butterstick-fpga/butterstick-hardware/hardware/ButterStick_r0.2/ButterStick.kicad_pcb

## KiCad design hardware/ButterStick_r0.2/ButterStick.kicad_pcb (2019-06-14)

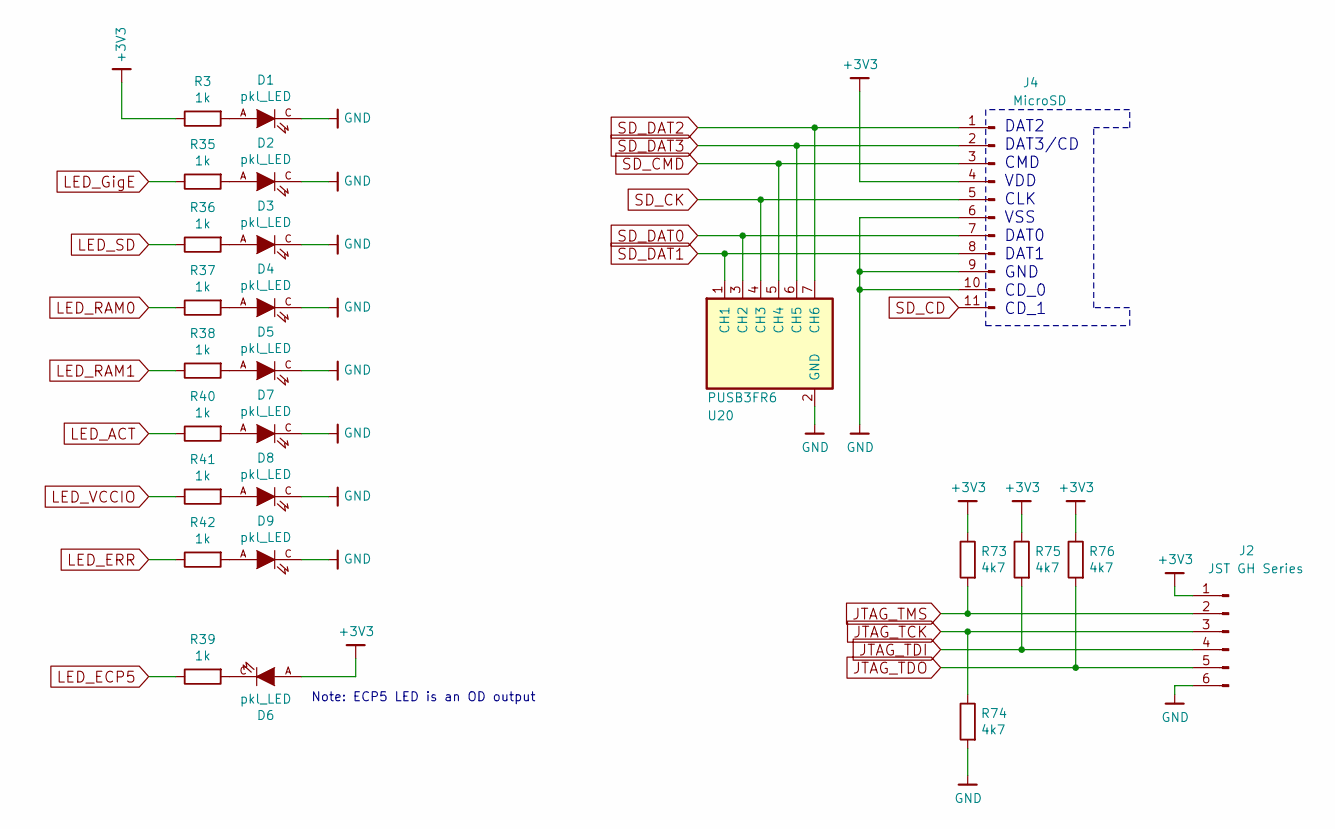
[picture p1: schematic fileIO.sch, ButterStick]

Parts:
D1, D2, D3, D4, D5, D6, D7, D8, D9: pkl_LED; D_0603
J2: JST GH Series; JST_GH_BM06B-GHS-TBT_06x1.25mm_Straight
J4: MicroSD; molex_microsd_1040310811
R3, R35, R36, R37, R38, R39, R40, R41, R42: 1k; R_0402
R73, R74, R75, R76: 4k7; R_0402
U20: PUSB3FR6; XSON7

Connections:
+3V3: D6.A, J2.1, J4.4, R3.1, R73.1, R75.1, R76.1; also elsewhere on the board
GND: D1.C, D2.C, D3.C, D4.C, D5.C, D7.C, D8.C, D9.C, J2.6, J4.6, J4.9, J4.10, R74.2, U20.2 (GND); also elsewhere on the board
JTAG_TCK: J2.3, R74.1; also elsewhere on the board
JTAG_TDI: J2.4, R75.2; also elsewhere on the board
JTAG_TDO: J2.5, R76.2; also elsewhere on the board
JTAG_TMS: J2.2, R73.2; also elsewhere on the board
LED_ACT: R40.1; also elsewhere on the board
LED_ECP5: R39.1; also elsewhere on the board
LED_ERR: R42.1; also elsewhere on the board
LED_GigE: R35.1; also elsewhere on the board
LED_RAM0: R37.1; also elsewhere on the board
LED_RAM1: R38.1; also elsewhere on the board
LED_SD: R36.1; also elsewhere on the board
LED_VCCIO: R41.1; also elsewhere on the board
unnamed: D1.A, R3.2
unnamed: D2.A, R35.2
unnamed: D3.A, R36.2
unnamed: D4.A, R37.2
unnamed: D5.A, R38.2
unnamed: D6.C, R39.2
unnamed: D7.A, R40.2
unnamed: D8.A, R41.2
unnamed: D9.A, R42.2
SD_CD: J4.11; also elsewhere on the board
SD_CK: J4.5, U20.4 (CH3); also elsewhere on the board
SD_CMD: J4.3, U20.5 (CH4); also elsewhere on the board
SD_DAT0: J4.7, U20.3 (CH2); also elsewhere on the board
SD_DAT1: J4.8, U20.1 (CH1); also elsewhere on the board
SD_DAT2: J4.1, U20.7 (CH6); also elsewhere on the board
SD_DAT3: J4.2, U20.6 (CH5); also elsewhere on the board

Notes on the sheet:
DAT2 DAT3/CD CMD VDD CLK VSS DAT0 DAT1 GND CD_0 CD_1
Note: ECP5 LED is an OD output

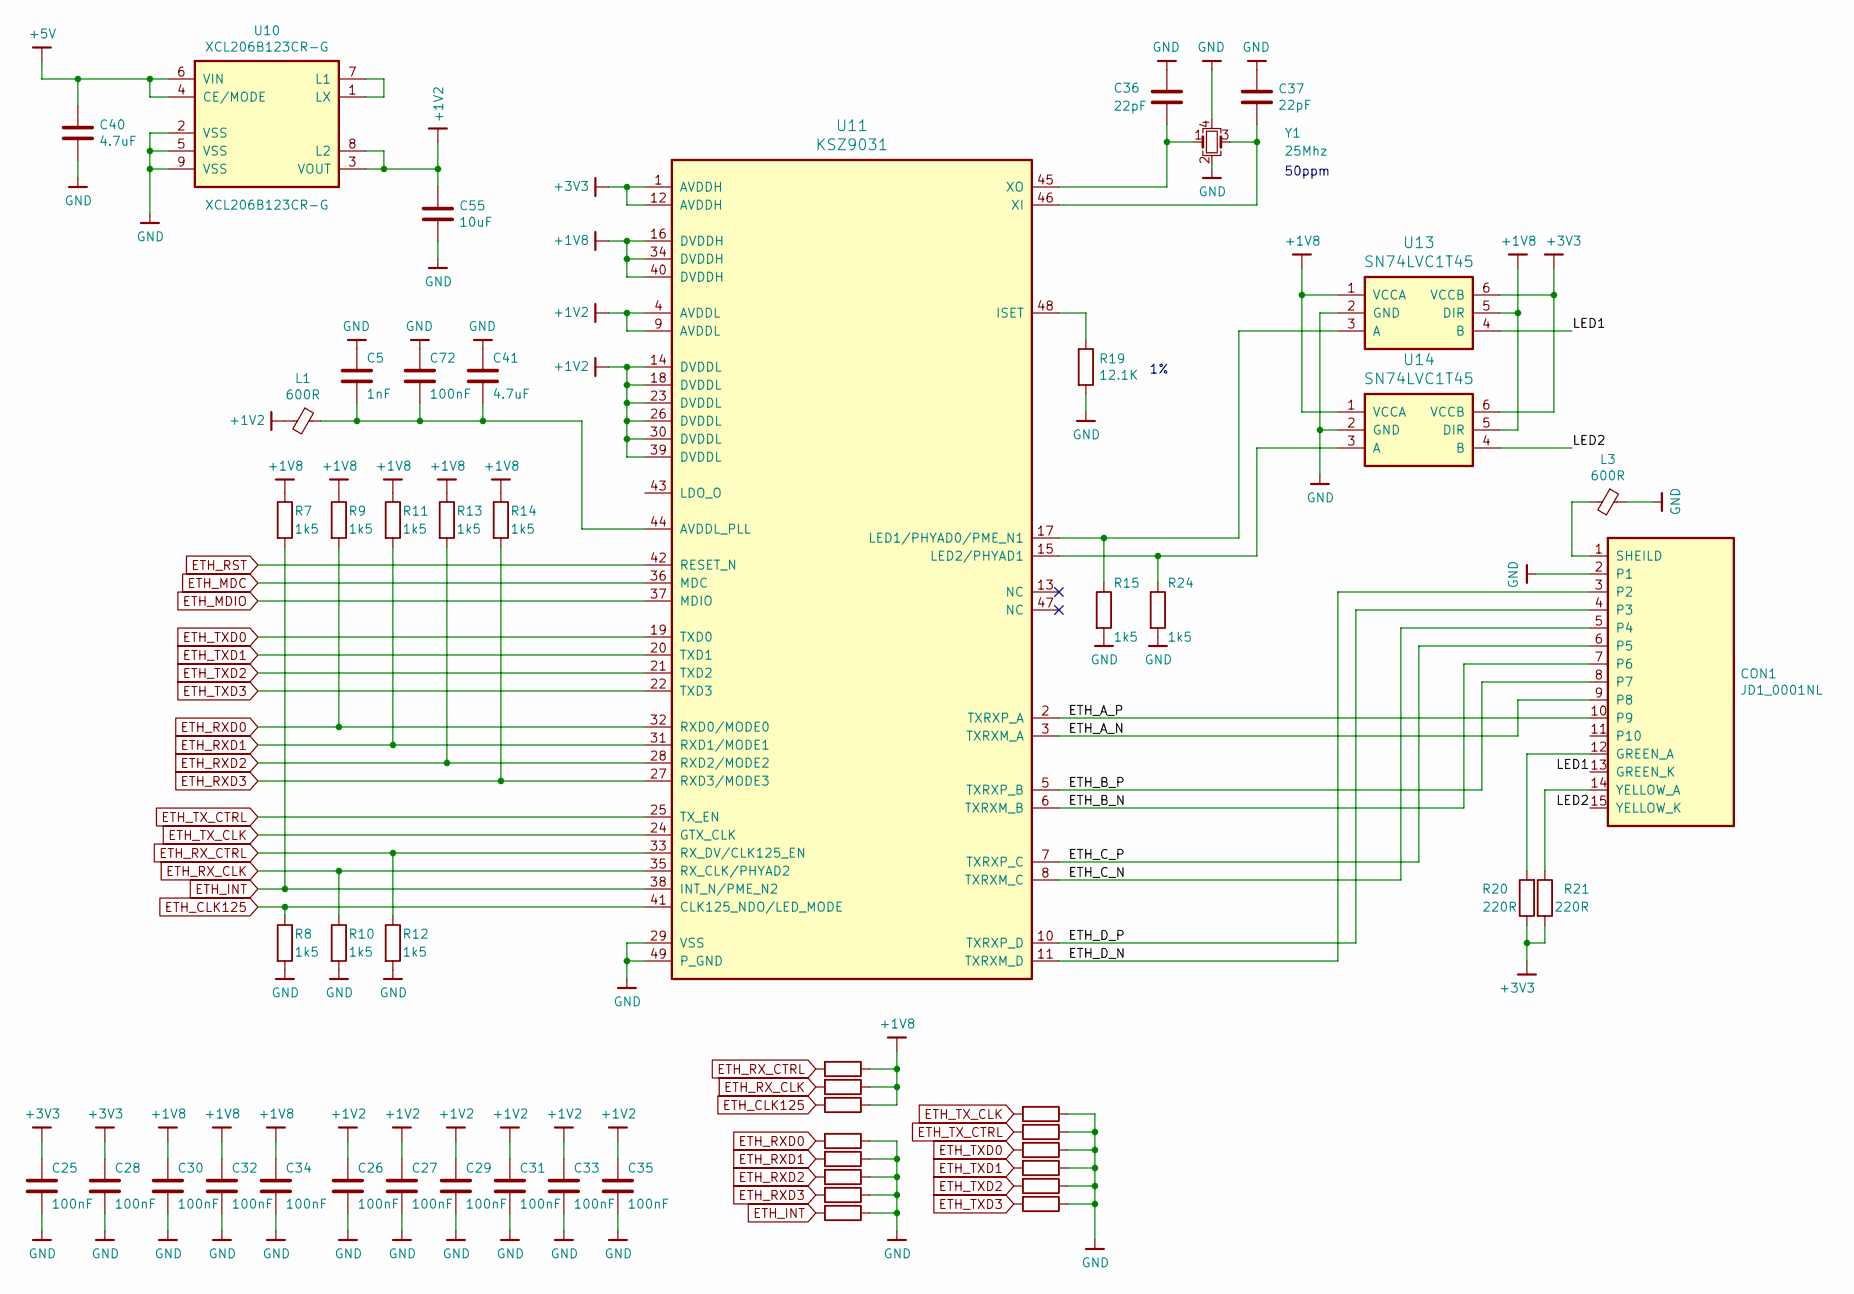
[picture p2: schematic fileEthernet.sch, ButterStick]

Parts:
C5: 1nF; C_0402
C25, C26, C27, C28, C29, C30, C31, C32, C33, C34, C35, C72: 100nF; C_0402
C36, C37: 22pF; C_0402
C40, C41: 4.7uF; C_0603
C55: 10uF; C_0603
CON1: JD1_0001NL; MAGJACK
L1: 600R; L_0402
L3: 600R; L_0603
R7, R8, R9, R10, R11, R12, R13, R14, R15, R24: 1k5; R_0402
R19: 12.1K; R_0603
R20, R21: 220R; R_0402
R48, R49, R50, R51, R52, R55, R64, R65, R67, R68, R69, R70, R71, R72: DNP; R_0402
U10: XCL206B123CR-G; CL-2025
U11: KSZ9031; QFN-48-1EP_7x7mm_Pitch0.5mm
U13, U14: SN74LVC1T45; SOT-666
Y1: 25Mhz; Oscillator_SMD_SeikoEpson_SG210-4pin_2.5x2.0mm

Connections:
+1V2: C26.1, C27.1, C29.1, C31.1, C33.1, C35.1, C55.1, L1.2, U10.3 (VOUT), U10.8 (L2), U11.4 (AVDDL~), U11.9 (AVDDL~), U11.14 (DVDDL), U11.18 (DVDDL), U11.23 (DVDDL), U11.26 (DVDDL), U11.30 (DVDDL), U11.39 (DVDDL)
+1V8: C30.1, C32.1, C34.1, R7.1, R9.1, R11.1, R13.1, R14.1, R48.1, R49.1, R50.1, U11.16 (DVDDH), U11.34 (DVDDH), U11.40 (DVDDH), U13.1 (VCCA), U13.5 (DIR), U14.1 (VCCA), U14.5 (DIR); also elsewhere on the board
+3V3: C25.1, C28.1, R20.1, R21.2, U11.1 (AVDDH), U11.12 (AVDDH), U13.6 (VCCB), U14.6 (VCCB); also elsewhere on the board
+5V: C40.1, U10.4 (CE/MODE), U10.6 (VIN); also elsewhere on the board
/sheetEthernet/ETH_A_N: CON1.9 (P8), U11.3 (TXRXM_A)
/sheetEthernet/ETH_A_P: CON1.10 (P9), U11.2 (TXRXP_A)
/sheetEthernet/ETH_B_N: CON1.7 (P6), U11.6 (TXRXM_B)
/sheetEthernet/ETH_B_P: CON1.8 (P7), U11.5 (TXRXP_B)
/sheetEthernet/ETH_C_N: CON1.5 (P4), U11.8 (TXRXM_C)
/sheetEthernet/ETH_C_P: CON1.6 (P5), U11.7 (TXRXP_C)
/sheetEthernet/ETH_D_N: CON1.3 (P2), U11.11 (TXRXM_D)
/sheetEthernet/ETH_D_P: CON1.4 (P3), U11.10 (TXRXP_D)
/sheetEthernet/LED1: CON1.13 (GREEN_K), U13.4 (B)
/sheetEthernet/LED2: CON1.15 (YELLOW_K), U14.4 (B)
ETH_CLK125: R8.1, R50.2, U11.41 (CLK125_NDO/LED_MODE); also elsewhere on the board
ETH_INT: R7.2, R65.2, U11.38 (INT_N/PME_N2); also elsewhere on the board
ETH_MDC: U11.36 (MDC); also elsewhere on the board
ETH_MDIO: U11.37 (MDIO); also elsewhere on the board
ETH_RST: U11.42 (RESET_N); also elsewhere on the board
ETH_RXD0: R9.2, R51.2, U11.32 (RXD0/MODE0); also elsewhere on the board
ETH_RXD1: R11.2, R52.2, U11.31 (RXD1/MODE1); also elsewhere on the board
ETH_RXD2: R13.2, R55.2, U11.28 (RXD2/MODE2); also elsewhere on the board
ETH_RXD3: R14.2, R64.2, U11.27 (RXD3/MODE3); also elsewhere on the board
ETH_RX_CLK: R10.1, R49.2, U11.35 (RX_CLK/PHYAD2); also elsewhere on the board
ETH_RX_CTRL: R12.1, R48.2, U11.33 (RX_DV/CLK125_EN); also elsewhere on the board
ETH_TXD0: R69.2, U11.19 (TXD0); also elsewhere on the board
ETH_TXD1: R70.2, U11.20 (TXD1); also elsewhere on the board
ETH_TXD2: R71.2, U11.21 (TXD2); also elsewhere on the board
ETH_TXD3: R72.2, U11.22 (TXD3); also elsewhere on the board
ETH_TX_CLK: R67.2, U11.24 (GTX_CLK); also elsewhere on the board
ETH_TX_CTRL: R68.2, U11.25 (TX_EN); also elsewhere on the board
GND: C5.1, C25.2, C26.2, C27.2, C28.2, C29.2, C30.2, C31.2, C32.2, C33.2, C34.2, C35.2, C36.1, C37.1, C40.2, C41.1, C55.2, C72.1, CON1.2 (P1), L3.1, R8.2, R10.2, R12.2, R15.2, R19.2, R24.2, R51.1, R52.1, R55.1, R64.1, R65.1, R67.1, R68.1, R69.1, R70.1, R71.1, R72.1, U10.2 (VSS), U10.5 (VSS), U10.9 (VSS), U11.29 (VSS), U11.49 (P_GND), U13.2 (GND), U14.2 (GND), Y1.2, Y1.4; also elsewhere on the board
unnamed: C36.2, U11.45 (XO), Y1.1
unnamed: C37.2, U11.46 (XI), Y1.3
unnamed: C5.2, C41.2, C72.2, L1.1, U11.44 (AVDDL_PLL)
unnamed: CON1.1 (SHEILD), L3.2
unnamed: CON1.12 (GREEN_A), R20.2
unnamed: CON1.14 (YELLOW_A), R21.1
unnamed: R15.1, U11.17 (LED1/PHYAD0/PME_N1), U13.3 (A)
unnamed: R19.1, U11.48 (ISET)
unnamed: R24.1, U11.15 (LED2/PHYAD1), U14.3 (A)
unnamed: U10.1 (LX), U10.7 (L1)

Notes on the sheet:
50ppm

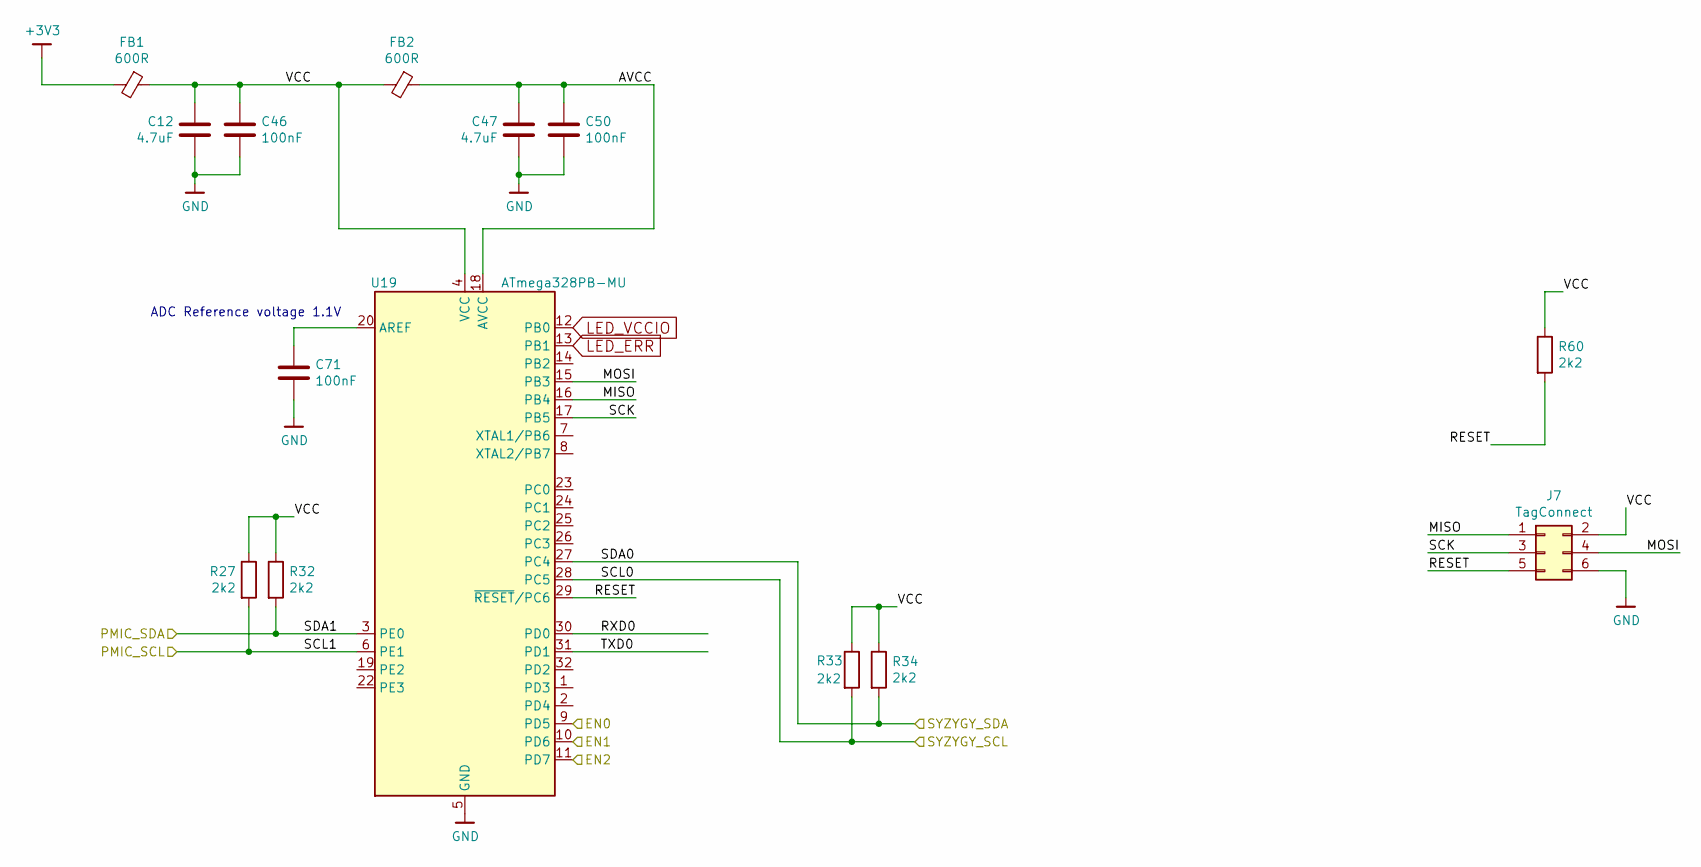
[picture p3: schematic SmartVIO.sch, ButterStick]

Parts:
C12, C47: 4.7uF; C_0603
C46, C50, C71: 100nF; C_0402
FB1, FB2: 600R; L_0402
J7: TagConnect; TC2030-NL_SMALL
R27, R32, R33, R34, R60: 2k2; R_0402
U19: ATmega328PB-MU; QFN-32-1EP_5x5mm_P0.5mm_EP3.1x3.1mm

Connections:
+3V3: FB1.2; also elsewhere on the board
/SmartVIO/AVCC: C47.1, C50.1, FB2.1, U19.18 (AVCC)
/SmartVIO/MISO: J7.1, U19.16 (PB4)
/SmartVIO/MOSI: J7.4, U19.15 (PB3)
/SmartVIO/PMIC_SCL: R27.2, U19.6 (PE1); also elsewhere on the board
/SmartVIO/PMIC_SDA: R32.2, U19.3 (PE0); also elsewhere on the board
/SmartVIO/RESET: J7.5, R60.2, U19.29 (~RESET~/PC6)
/SmartVIO/RXD0: U19.30 (PD0)
/SmartVIO/SCK: J7.3, U19.17 (PB5)
/SmartVIO/SYZYGY_SCL: R33.2, U19.28 (PC5); also elsewhere on the board
/SmartVIO/SYZYGY_SDA: R34.2, U19.27 (PC4); also elsewhere on the board
/SmartVIO/TXD0: U19.31 (PD1)
/SmartVIO/VCC: C12.1, C46.1, FB1.1, FB2.2, J7.2, R27.1, R32.1, R33.1, R34.1, R60.1, U19.4 (VCC)
/SyzygyPort0/EN: U19.9 (PD5); also elsewhere on the board
/SyzygyPort1/EN: U19.10 (PD6); also elsewhere on the board
/SyzygyPort2/EN: U19.11 (PD7); also elsewhere on the board
GND: C12.2, C46.2, C47.2, C50.2, C71.2, J7.6, U19.5 (GND), U19.21 (GND), U19.33 (GND); also elsewhere on the board
LED_ERR: U19.13 (PB1); also elsewhere on the board
LED_VCCIO: U19.12 (PB0); also elsewhere on the board
unnamed: C71.1, U19.20 (AREF)

Notes on the sheet:
ADC Reference voltage 1.1V

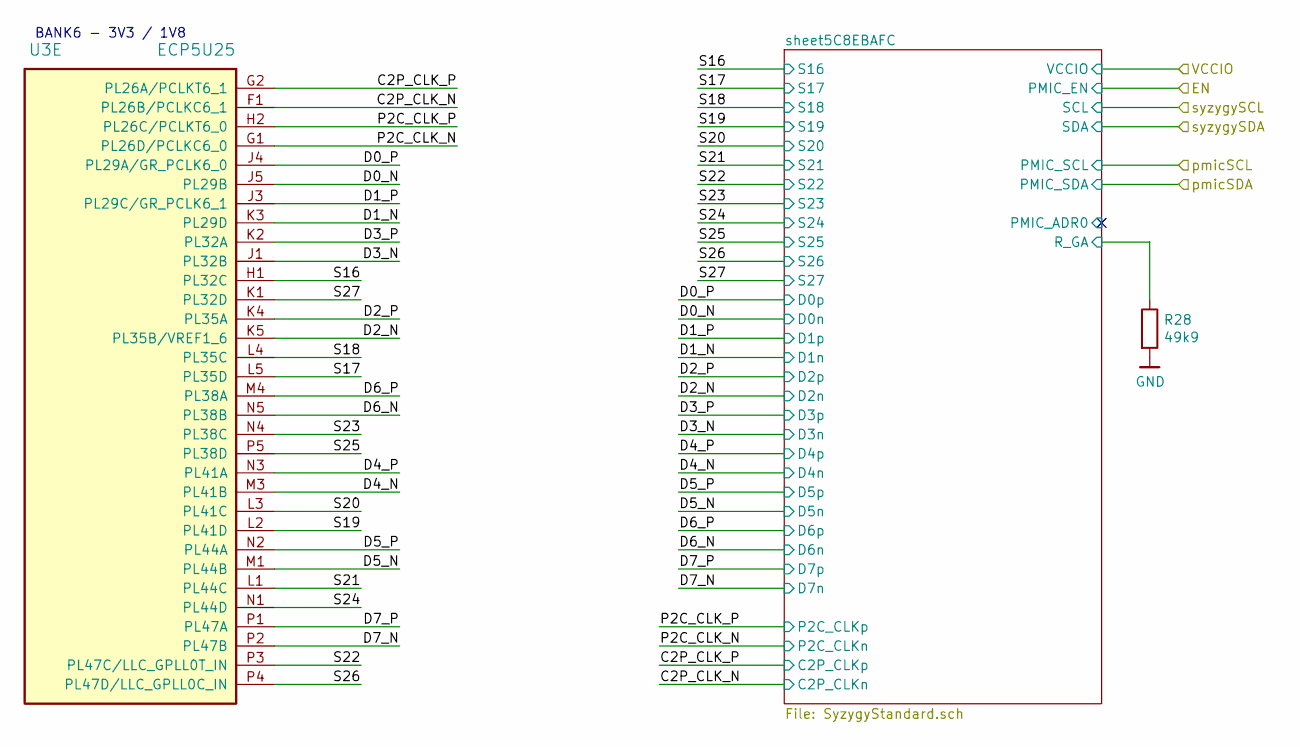
[picture p4: schematic SYZYGY_PORT2.sch, ButterStick]

Parts:
R28: 49k9; R_0402
U3: ECP5U25; caBGA_381_17x17

Connections:
/SyzygyPort2/C2P_CLK_N: U3.F1 (PL26B/PCLKC6_1); also elsewhere on the board
/SyzygyPort2/C2P_CLK_P: U3.G2 (PL26A/PCLKT6_1); also elsewhere on the board
/SyzygyPort2/D0_N: U3.J5 (PL29B); also elsewhere on the board
/SyzygyPort2/D0_P: U3.J4 (PL29A/GR_PCLK6_0); also elsewhere on the board
/SyzygyPort2/D1_N: U3.K3 (PL29D); also elsewhere on the board
/SyzygyPort2/D1_P: U3.J3 (PL29C/GR_PCLK6_1); also elsewhere on the board
/SyzygyPort2/D2_N: U3.K5 (PL35B/VREF1_6); also elsewhere on the board
/SyzygyPort2/D2_P: U3.K4 (PL35A); also elsewhere on the board
/SyzygyPort2/D3_N: U3.J1 (PL32B); also elsewhere on the board
/SyzygyPort2/D3_P: U3.K2 (PL32A); also elsewhere on the board
/SyzygyPort2/D4_N: U3.M3 (PL41B); also elsewhere on the board
/SyzygyPort2/D4_P: U3.N3 (PL41A); also elsewhere on the board
/SyzygyPort2/D5_N: U3.M1 (PL44B); also elsewhere on the board
/SyzygyPort2/D5_P: U3.N2 (PL44A); also elsewhere on the board
/SyzygyPort2/D6_N: U3.N5 (PL38B); also elsewhere on the board
/SyzygyPort2/D6_P: U3.M4 (PL38A); also elsewhere on the board
/SyzygyPort2/D7_N: U3.P2 (PL47B); also elsewhere on the board
/SyzygyPort2/D7_P: U3.P1 (PL47A); also elsewhere on the board
/SyzygyPort2/P2C_CLK_N: U3.G1 (PL26D/PCLKC6_0); also elsewhere on the board
/SyzygyPort2/P2C_CLK_P: U3.H2 (PL26C/PCLKT6_0); also elsewhere on the board
/SyzygyPort2/S16: U3.H1 (PL32C); also elsewhere on the board
/SyzygyPort2/S17: U3.L5 (PL35D); also elsewhere on the board
/SyzygyPort2/S18: U3.L4 (PL35C); also elsewhere on the board
/SyzygyPort2/S19: U3.L2 (PL41D); also elsewhere on the board
/SyzygyPort2/S20: U3.L3 (PL41C); also elsewhere on the board
/SyzygyPort2/S21: U3.L1 (PL44C); also elsewhere on the board
/SyzygyPort2/S22: U3.P3 (PL47C/LLC_GPLL0T_IN); also elsewhere on the board
/SyzygyPort2/S23: U3.N4 (PL38C); also elsewhere on the board
/SyzygyPort2/S24: U3.N1 (PL44D); also elsewhere on the board
/SyzygyPort2/S25: U3.P5 (PL38D); also elsewhere on the board
/SyzygyPort2/S26: U3.P4 (PL47D/LLC_GPLL0C_IN); also elsewhere on the board
/SyzygyPort2/S27: U3.K1 (PL32D); also elsewhere on the board
/SyzygyPort2/sheet5C8EBAFC/R_GA: R28.1; also elsewhere on the board
GND: R28.2; also elsewhere on the board

Notes on the sheet:
BANK6 - 3V3 / 1V8

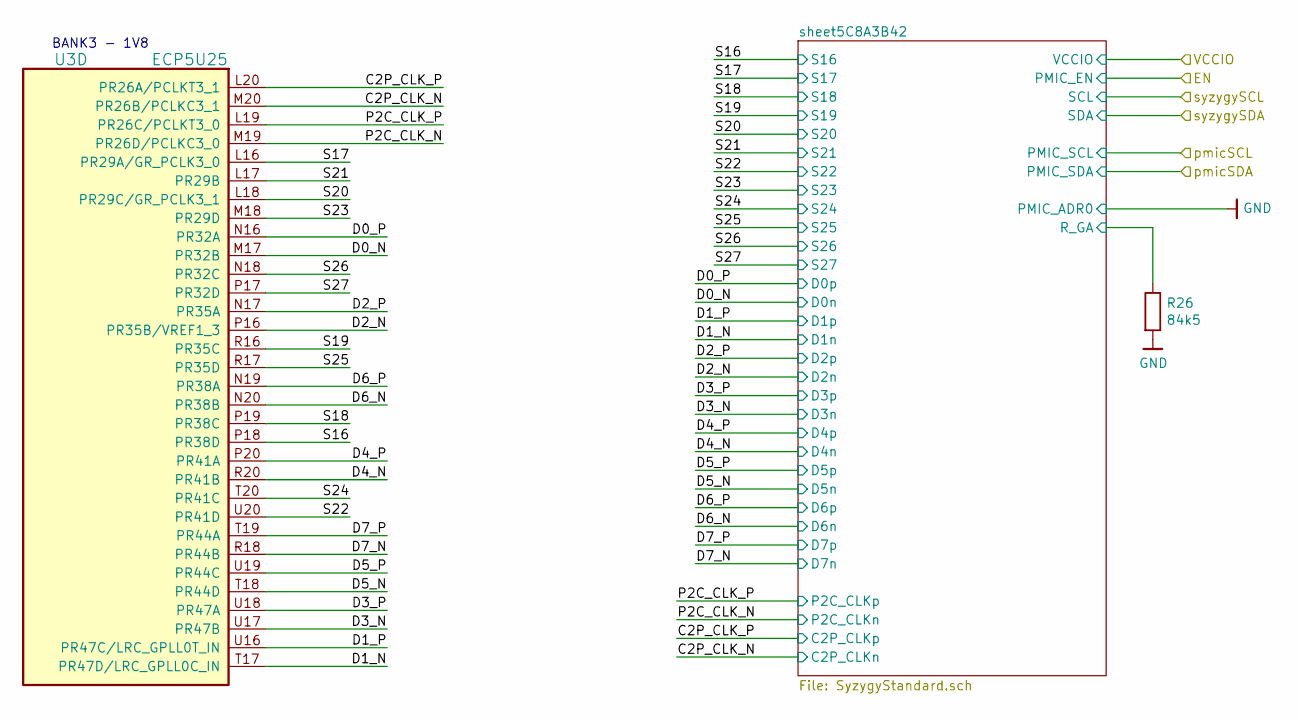
[picture p5: schematic SYZYGY_PORT1.sch, ButterStick]

Parts:
R26: 84k5; R_0402
U3: ECP5U25; caBGA_381_17x17

Connections:
/SyzygyPort1/C2P_CLK_N: U3.M20 (PR26B/PCLKC3_1); also elsewhere on the board
/SyzygyPort1/C2P_CLK_P: U3.L20 (PR26A/PCLKT3_1); also elsewhere on the board
/SyzygyPort1/D0_N: U3.M17 (PR32B); also elsewhere on the board
/SyzygyPort1/D0_P: U3.N16 (PR32A); also elsewhere on the board
/SyzygyPort1/D1_N: U3.T17 (PR47D/LRC_GPLL0C_IN); also elsewhere on the board
/SyzygyPort1/D1_P: U3.U16 (PR47C/LRC_GPLL0T_IN); also elsewhere on the board
/SyzygyPort1/D2_N: U3.P16 (PR35B/VREF1_3); also elsewhere on the board
/SyzygyPort1/D2_P: U3.N17 (PR35A); also elsewhere on the board
/SyzygyPort1/D3_N: U3.U17 (PR47B); also elsewhere on the board
/SyzygyPort1/D3_P: U3.U18 (PR47A); also elsewhere on the board
/SyzygyPort1/D4_N: U3.R20 (PR41B); also elsewhere on the board
/SyzygyPort1/D4_P: U3.P20 (PR41A); also elsewhere on the board
/SyzygyPort1/D5_N: U3.T18 (PR44D); also elsewhere on the board
/SyzygyPort1/D5_P: U3.U19 (PR44C); also elsewhere on the board
/SyzygyPort1/D6_N: U3.N20 (PR38B); also elsewhere on the board
/SyzygyPort1/D6_P: U3.N19 (PR38A); also elsewhere on the board
/SyzygyPort1/D7_N: U3.R18 (PR44B); also elsewhere on the board
/SyzygyPort1/D7_P: U3.T19 (PR44A); also elsewhere on the board
/SyzygyPort1/P2C_CLK_N: U3.M19 (PR26D/PCLKC3_0); also elsewhere on the board
/SyzygyPort1/P2C_CLK_P: U3.L19 (PR26C/PCLKT3_0); also elsewhere on the board
/SyzygyPort1/S16: U3.P18 (PR38D); also elsewhere on the board
/SyzygyPort1/S17: U3.L16 (PR29A/GR_PCLK3_0); also elsewhere on the board
/SyzygyPort1/S18: U3.P19 (PR38C); also elsewhere on the board
/SyzygyPort1/S19: U3.R16 (PR35C); also elsewhere on the board
/SyzygyPort1/S20: U3.L18 (PR29C/GR_PCLK3_1); also elsewhere on the board
/SyzygyPort1/S21: U3.L17 (PR29B); also elsewhere on the board
/SyzygyPort1/S22: U3.U20 (PR41D); also elsewhere on the board
/SyzygyPort1/S23: U3.M18 (PR29D); also elsewhere on the board
/SyzygyPort1/S24: U3.T20 (PR41C); also elsewhere on the board
/SyzygyPort1/S25: U3.R17 (PR35D); also elsewhere on the board
/SyzygyPort1/S26: U3.N18 (PR32C); also elsewhere on the board
/SyzygyPort1/S27: U3.P17 (PR32D); also elsewhere on the board
/SyzygyPort1/sheet5C8A3B42/R_GA: R26.1; also elsewhere on the board
GND: R26.2; also elsewhere on the board

Notes on the sheet:
BANK3 - 1V8

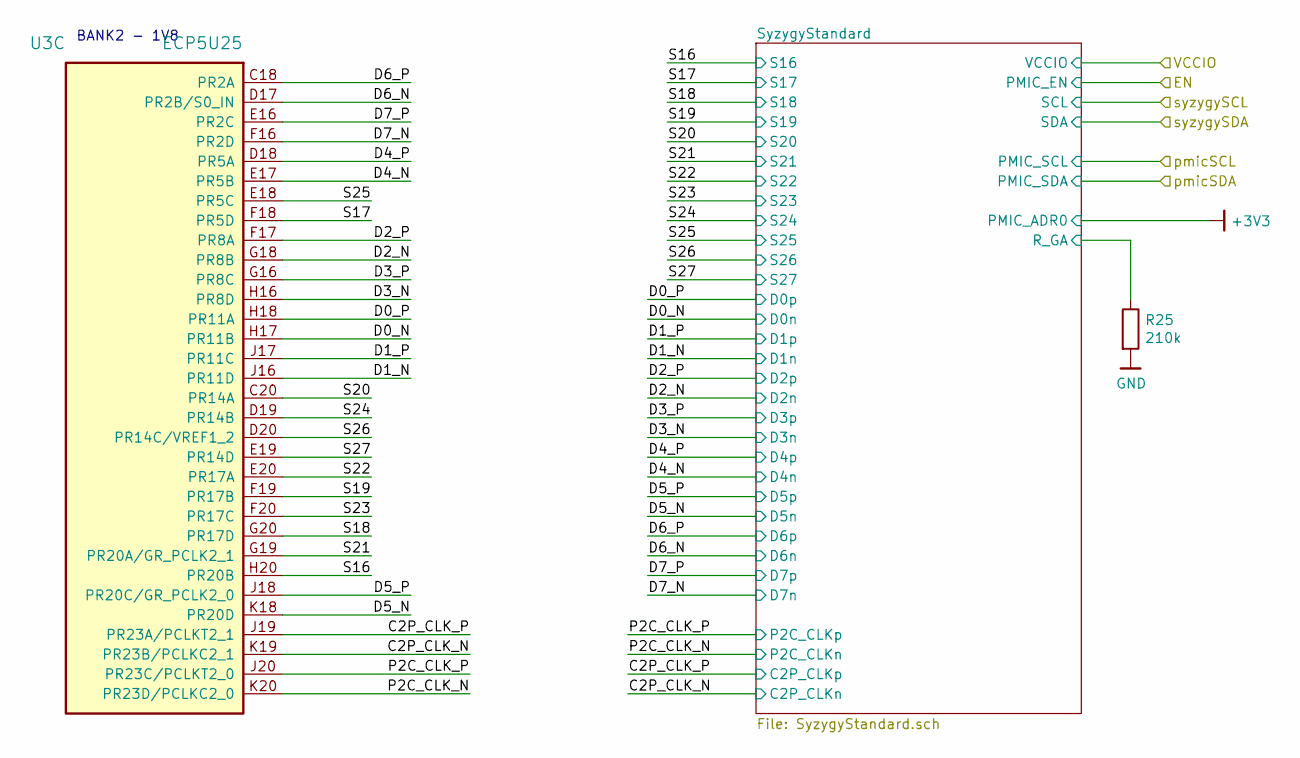
[picture p6: schematic SYZYGY_PORT0.sch, ButterStick]

Parts:
R25: 210k; R_0402
U3: ECP5U25; caBGA_381_17x17

Connections:
/SyzygyPort0/C2P_CLK_N: U3.K19 (PR23B/PCLKC2_1); also elsewhere on the board
/SyzygyPort0/C2P_CLK_P: U3.J19 (PR23A/PCLKT2_1); also elsewhere on the board
/SyzygyPort0/D0_N: U3.H17 (PR11B); also elsewhere on the board
/SyzygyPort0/D0_P: U3.H18 (PR11A); also elsewhere on the board
/SyzygyPort0/D1_N: U3.J16 (PR11D); also elsewhere on the board
/SyzygyPort0/D1_P: U3.J17 (PR11C); also elsewhere on the board
/SyzygyPort0/D2_N: U3.G18 (PR8B); also elsewhere on the board
/SyzygyPort0/D2_P: U3.F17 (PR8A); also elsewhere on the board
/SyzygyPort0/D3_N: U3.H16 (PR8D); also elsewhere on the board
/SyzygyPort0/D3_P: U3.G16 (PR8C); also elsewhere on the board
/SyzygyPort0/D4_N: U3.E17 (PR5B); also elsewhere on the board
/SyzygyPort0/D4_P: U3.D18 (PR5A); also elsewhere on the board
/SyzygyPort0/D5_N: U3.K18 (PR20D); also elsewhere on the board
/SyzygyPort0/D5_P: U3.J18 (PR20C/GR_PCLK2_0); also elsewhere on the board
/SyzygyPort0/D6_N: U3.D17 (PR2B/S0_IN); also elsewhere on the board
/SyzygyPort0/D6_P: U3.C18 (PR2A); also elsewhere on the board
/SyzygyPort0/D7_N: U3.F16 (PR2D); also elsewhere on the board
/SyzygyPort0/D7_P: U3.E16 (PR2C); also elsewhere on the board
/SyzygyPort0/P2C_CLK_N: U3.K20 (PR23D/PCLKC2_0); also elsewhere on the board
/SyzygyPort0/P2C_CLK_P: U3.J20 (PR23C/PCLKT2_0); also elsewhere on the board
/SyzygyPort0/S16: U3.H20 (PR20B); also elsewhere on the board
/SyzygyPort0/S17: U3.F18 (PR5D); also elsewhere on the board
/SyzygyPort0/S18: U3.G20 (PR17D); also elsewhere on the board
/SyzygyPort0/S19: U3.F19 (PR17B); also elsewhere on the board
/SyzygyPort0/S20: U3.C20 (PR14A); also elsewhere on the board
/SyzygyPort0/S21: U3.G19 (PR20A/GR_PCLK2_1); also elsewhere on the board
/SyzygyPort0/S22: U3.E20 (PR17A); also elsewhere on the board
/SyzygyPort0/S23: U3.F20 (PR17C); also elsewhere on the board
/SyzygyPort0/S24: U3.D19 (PR14B); also elsewhere on the board
/SyzygyPort0/S25: U3.E18 (PR5C); also elsewhere on the board
/SyzygyPort0/S26: U3.D20 (PR14C/VREF1_2); also elsewhere on the board
/SyzygyPort0/S27: U3.E19 (PR14D); also elsewhere on the board
/SyzygyPort0/SyzygyStandard/R_GA: R25.1; also elsewhere on the board
GND: R25.2; also elsewhere on the board

Notes on the sheet:
BANK2 - 1V8

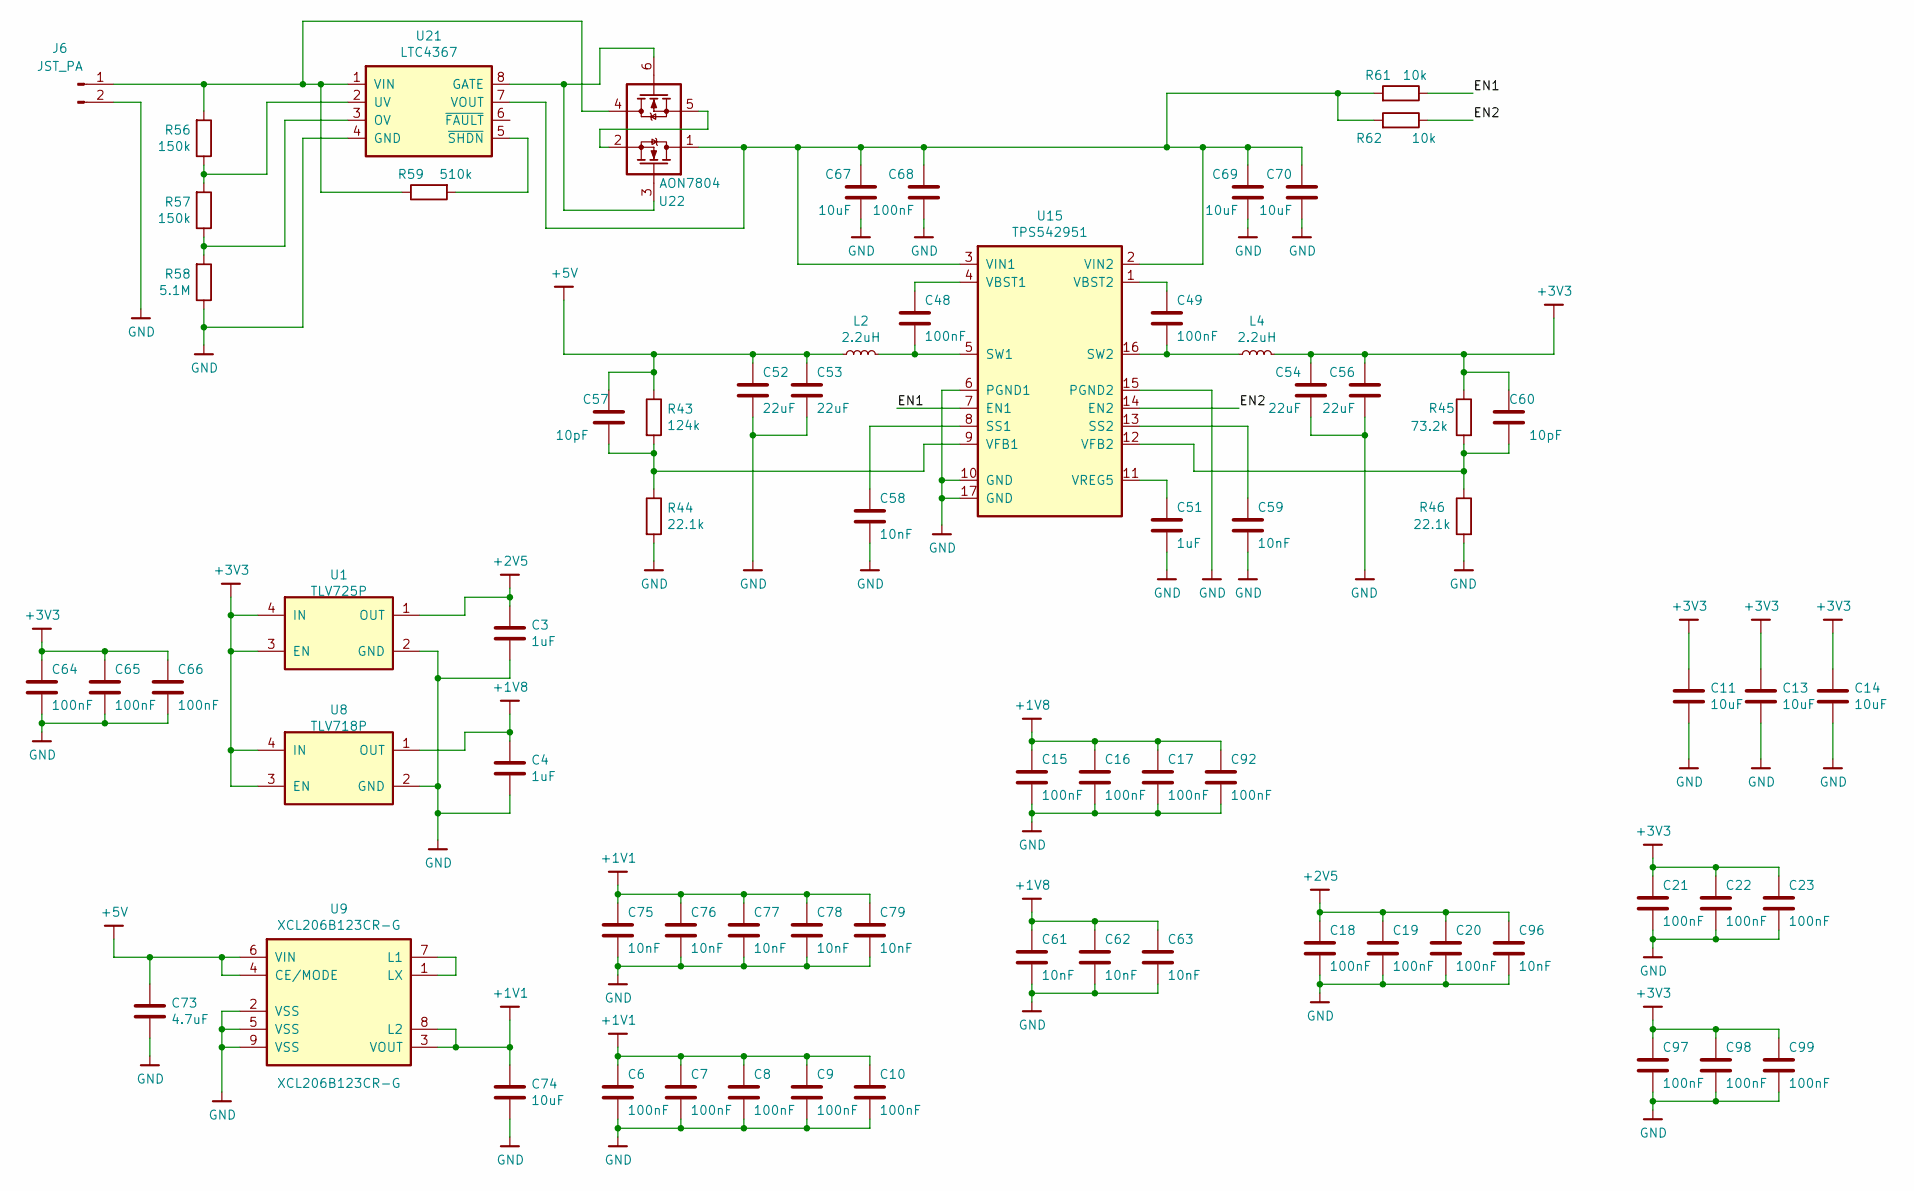
[picture p7: schematic filePower.sch, ButterStick]

Parts:
C3, C4, C51: 1uF; C_0402
C6, C7, C8, C9, C10, C15, C16, C17, C18, C19, C20, C21, C22, C23, C48, C49, C64, C65, C66, C92, C97, C98, C99: 100nF; C_0402
C11, C13, C14, C74: 10uF; C_0603
C52, C53, C54, C56: 22uF; C_0805
C57, C60: 10pF; C_0402
C58, C59, C61, C62, C63, C75, C76, C77, C78, C79, C96: 10nF; C_0402
C67, C69, C70: 10uF; C_0805
C68: 100nF; C_0603
C73: 4.7uF; C_0603
J6: JST_PA; SB02B-PASK-2
L2, L4: 2.2uH; L_Taiyo-Yuden_MD-5050
R43: 124k; R_0402
R44, R46: 22.1k; R_0402
R45: 73.2k; R_0402
R56, R57: 150k; R_0402
R58: 5.1M; R_0402
R59: 510k; R_0402
R61, R62: 10k; R_0402
U1: TLV725P; X2SON
U8: TLV718P; X2SON
U9: XCL206B123CR-G; CL-2025
U15: TPS542951; QFN-16-1EP_4x4mm_P0.65mm_EP2.7x2.7mm_ThermalVias
U21: LTC4367; MSOP-8_3x3mm_P0.65mm
U22: AON7804; DFN3X3_8L_EP2_P

Connections:
+1V1: C6.1, C7.1, C8.1, C9.1, C10.1, C74.1, C75.1, C76.1, C77.1, C78.1, C79.1, U9.3 (VOUT), U9.8 (L2); also elsewhere on the board
+1V8: C4.1, C15.1, C16.1, C17.1, C61.1, C62.1, C63.1, C92.1, U8.1 (OUT); also elsewhere on the board
+2V5: C3.1, C18.1, C19.1, C20.1, C96.1, U1.1 (OUT); also elsewhere on the board
+3V3: C11.1, C13.1, C14.1, C21.1, C22.1, C23.1, C54.1, C56.1, C60.1, C64.1, C65.1, C66.1, C97.1, C98.1, C99.1, L4.2, R45.1, U1.3 (EN), U1.4 (IN), U8.3 (EN), U8.4 (IN); also elsewhere on the board
+5V: C52.1, C53.1, C57.1, C73.1, L2.1, R43.1, U9.4 (CE/MODE), U9.6 (VIN); also elsewhere on the board
/sheetPower/EN1: R61.1, U15.7 (EN1)
/sheetPower/EN2: R62.1, U15.14 (EN2)
GND: C3.2, C4.2, C6.2, C7.2, C8.2, C9.2, C10.2, C11.2, C13.2, C14.2, C15.2, C16.2, C17.2, C18.2, C19.2, C20.2, C21.2, C22.2, C23.2, C51.2, C52.2, C53.2, C54.2, C56.2, C58.2, C59.2, C61.2, C62.2, C63.2, C64.2, C65.2, C66.2, C67.2, C68.2, C69.2, C70.2, C73.2, C74.2, C75.2, C76.2, C77.2, C78.2, C79.2, C92.2, C96.2, C97.2, C98.2, C99.2, J6.2, R44.2, R46.2, R58.1, U1.2 (GND), U8.2 (GND), U9.2 (VSS), U9.5 (VSS), U9.9 (VSS), U15.6 (PGND1), U15.10 (GND), U15.15 (PGND2), U15.17 (GND), U21.4 (GND); also elsewhere on the board
unnamed: C48.1, U15.4 (VBST1)
unnamed: C48.2, L2.2, U15.5 (SW1)
unnamed: C49.1, U15.1 (VBST2)
unnamed: C49.2, L4.1, U15.16 (SW2)
unnamed: C51.1, U15.11 (VREG5)
unnamed: C57.2, R43.2, R44.1, U15.9 (VFB1)
unnamed: C58.1, U15.8 (SS1)
unnamed: C59.1, U15.13 (SS2)
unnamed: C60.2, R45.2, R46.1, U15.12 (VFB2)
unnamed: C67.1, C68.1, C69.1, C70.1, R61.2, R62.2, U15.2 (VIN2), U15.3 (VIN1), U21.7 (VOUT), U22.1 (D)
unnamed: J6.1, R56.2, R59.1, U21.1 (VIN), U22.4 (D)
unnamed: R56.1, R57.2, U21.2 (UV)
unnamed: R57.1, R58.2, U21.3 (OV)
unnamed: R59.2, U21.5 (~SHDN)
unnamed: U9.1 (LX), U9.7 (L1)
unnamed: U21.8 (GATE), U22.3 (G), U22.6 (G)
unnamed: U22.2 (S), U22.5 (S)
