butterstick-fpga/butterstick-hardware/hardware/ButterStick_r0.2/ButterStick.kicad_pcb

## KiCad design hardware/ButterStick_r0.2/ButterStick.kicad_pcb (continued)

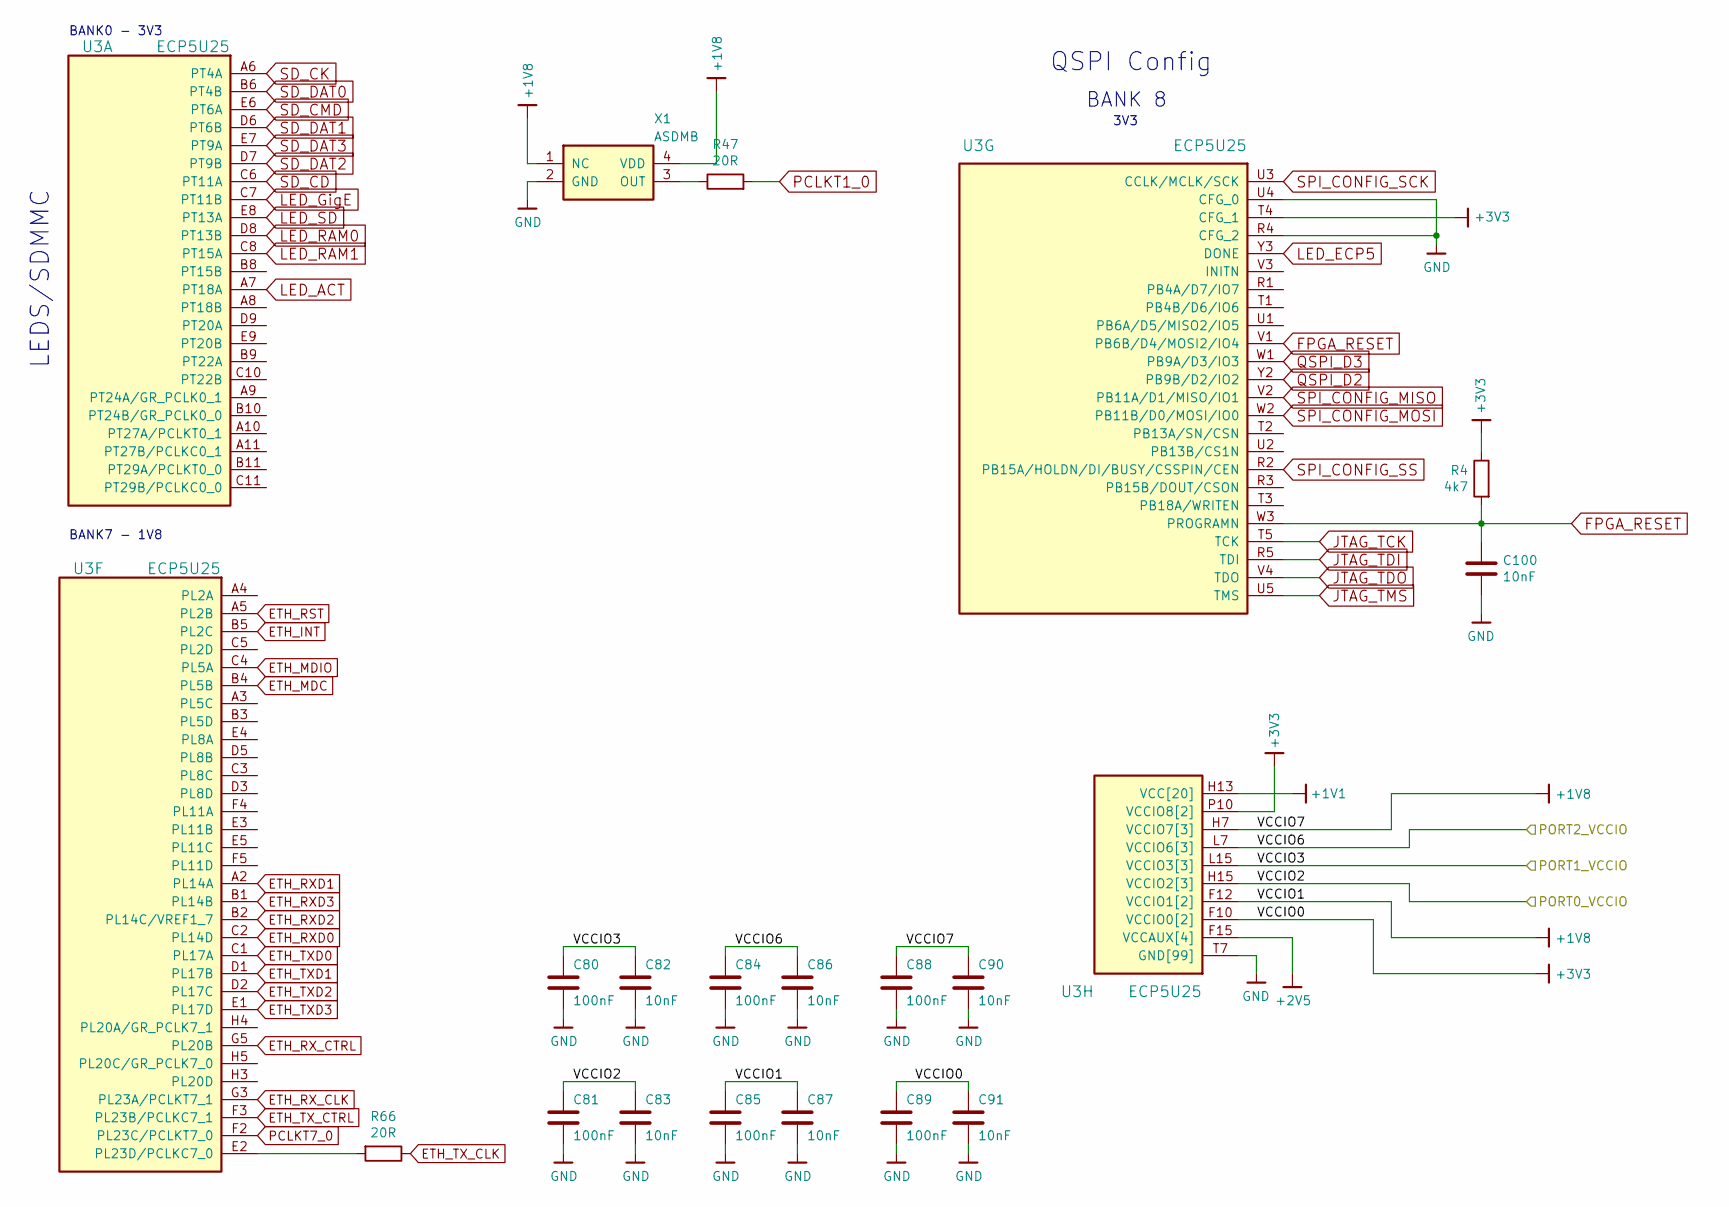
[picture p8: schematic fileFPGA.sch, ButterStick]

Parts:
C80, C81, C84, C85, C88, C89: 100nF; C_0402
C82, C83, C86, C87, C90, C91, C100: 10nF; C_0402
R4: 4k7; R_0402
R47, R66: 20R; R_0402
U3: ECP5U25; caBGA_381_17x17
X1: ASDMB; Oscillator_SMD_SeikoEpson_SG210-4pin_2.5x2.0mm

Connections:
+1V1: U3.H8 (VCC[20]), U3.H9 (VCC[20]), U3.H10 (VCC[20]), U3.H11 (VCC[20]), U3.H12 (VCC[20]), U3.H13 (VCC[20]), U3.J8 (VCC[20]), U3.J13 (VCC[20]), U3.K8 (VCC[20]), U3.K13 (VCC[20]), U3.L8 (VCC[20]), U3.L13 (VCC[20]), U3.M8 (VCC[20]), U3.M13 (VCC[20]), U3.N8 (VCC[20]), U3.N9 (VCC[20]), U3.N10 (VCC[20]), U3.N11 (VCC[20]), U3.N12 (VCC[20]), U3.N13 (VCC[20]); also elsewhere on the board
+1V8: C85.1, C87.1, C88.1, C90.1, U3.F11 (VCCIO1[2]), U3.F12 (VCCIO1[2]), U3.H6 (VCCIO7[3]), U3.H7 (VCCIO7[3]), U3.J6 (VCCIO7[3]), X1.1 (NC), X1.4 (VDD); also elsewhere on the board
+2V5: U3.F6 (VCCAUX[4]), U3.F15 (VCCAUX[4]), U3.P6 (VCCAUX[4]), U3.P15 (VCCAUX[4]); also elsewhere on the board
+3V3: C89.1, C91.1, R4.1, U3.F9 (VCCIO0[2]), U3.F10 (VCCIO0[2]), U3.P9 (VCCIO8[2]), U3.P10 (VCCIO8[2]), U3.T4 (CFG_1); also elsewhere on the board
ETH_INT: U3.B5 (PL2C); also elsewhere on the board
ETH_MDC: U3.B4 (PL5B); also elsewhere on the board
ETH_MDIO: U3.C4 (PL5A); also elsewhere on the board
ETH_RST: U3.A5 (PL2B); also elsewhere on the board
ETH_RXD0: U3.C2 (PL14D); also elsewhere on the board
ETH_RXD1: U3.A2 (PL14A); also elsewhere on the board
ETH_RXD2: U3.B2 (PL14C/VREF1_7); also elsewhere on the board
ETH_RXD3: U3.B1 (PL14B); also elsewhere on the board
ETH_RX_CLK: U3.G3 (PL23A/PCLKT7_1); also elsewhere on the board
ETH_RX_CTRL: U3.G5 (PL20B); also elsewhere on the board
ETH_TXD0: U3.C1 (PL17A); also elsewhere on the board
ETH_TXD1: U3.D1 (PL17B); also elsewhere on the board
ETH_TXD2: U3.D2 (PL17C); also elsewhere on the board
ETH_TXD3: U3.E1 (PL17D); also elsewhere on the board
ETH_TX_CLK: R66.1; also elsewhere on the board
ETH_TX_CTRL: U3.F3 (PL23B/PCLKC7_1); also elsewhere on the board
FPGA_RESET: C100.1, R4.2, U3.V1 (PB6B/D4/MOSI2/IO4), U3.W3 (PROGRAMN)
GND: C80.2, C81.2, C82.2, C83.2, C84.2, C85.2, C86.2, C87.2, C88.2, C89.2, C90.2, C91.2, C100.2, U3.B7 (GND[99]), U3.B14 (GND[99]), U3.C19 (GND[99]), U3.D4 (GND[99]), U3.F7 (GND[99]), U3.F8 (GND[99]), U3.F13 (GND[99]), U3.F14 (GND[99]), U3.G4 (GND[99]), U3.G6 (GND[99]), U3.G7 (GND[99]), U3.G8 (GND[99]), U3.G9 (GND[99]), U3.G10 (GND[99]), U3.G11 (GND[99]), U3.G12 (GND[99]), U3.G13 (GND[99]), U3.G14 (GND[99]), U3.G15 (GND[99]), U3.G17 (GND[99]), U3.H19 (GND[99]), U3.J2 (GND[99]), U3.J7 (GND[99]), U3.J9 (GND[99]), U3.J10 (GND[99]), U3.J11 (GND[99]), U3.J12 (GND[99]), U3.J14 (GND[99]), U3.K6 (GND[99]), U3.K7 (GND[99]), U3.K9 (GND[99]), U3.K10 (GND[99]), U3.K11 (GND[99]), U3.K12 (GND[99]), U3.K14 (GND[99]), U3.K15 (GND[99]), U3.L9 (GND[99]), U3.L10 (GND[99]), U3.L11 (GND[99]), U3.L12 (GND[99]), U3.M2 (GND[99]), U3.M7 (GND[99]), U3.M9 (GND[99]), U3.M10 (GND[99]), U3.M11 (GND[99]), U3.M12 (GND[99]), U3.M14 (GND[99]), U3.M16 (GND[99]), U3.N6 (GND[99]), U3.N7 (GND[99]), U3.N14 (GND[99]), U3.N15 (GND[99]), U3.P7 (GND[99]), U3.P8 (GND[99]), U3.P11 (GND[99]), U3.P12 (GND[99]), U3.P13 (GND[99]), U3.P14 (GND[99]), U3.R4 (CFG_2), U3.R19 (GND[99]), U3.T6 (GND[99]), U3.T7 (GND[99]), U3.T8 (GND[99]), U3.T9 (GND[99]), U3.T10 (GND[99]), U3.U4 (CFG_0), U3.U6 (GND[99]), U3.U7 (GND[99]), U3.U8 (GND[99]), U3.U9 (GND[99]), U3.U10 (GND[99]), U3.U11 (GND[99]), U3.U12 (GND[99]), U3.U13 (GND[99]), U3.U14 (GND[99]), U3.V5 (GND[99]), U3.V6 (GND[99]), U3.V7 (GND[99]), U3.V8 (GND[99]), U3.V9 (GND[99]), U3.V10 (GND[99]), U3.V11 (GND[99]), U3.V12 (GND[99]), U3.V13 (GND[99]), U3.V14 (GND[99]), U3.V15 (GND[99]), U3.V16 (GND[99]), U3.V19 (GND[99]), U3.V20 (GND[99]), U3.W6 (GND[99]), U3.W7 (GND[99]), U3.W12 (GND[99]), U3.W15 (GND[99]), U3.W16 (GND[99]), U3.W19 (GND[99]), U3.Y5 (GND[99]), U3.Y6 (GND[99]), U3.Y7 (GND[99]), U3.Y8 (GND[99]), U3.Y11 (GND[99]), U3.Y12 (GND[99]), X1.2 (GND); also elsewhere on the board
JTAG_TCK: U3.T5 (TCK); also elsewhere on the board
JTAG_TDI: U3.R5 (TDI); also elsewhere on the board
JTAG_TDO: U3.V4 (TDO); also elsewhere on the board
JTAG_TMS: U3.U5 (TMS); also elsewhere on the board
LED_ACT: U3.A7 (PT18A); also elsewhere on the board
LED_ECP5: U3.Y3 (DONE); also elsewhere on the board
LED_GigE: U3.C7 (PT11B); also elsewhere on the board
LED_RAM0: U3.D8 (PT13B); also elsewhere on the board
LED_RAM1: U3.C8 (PT15A); also elsewhere on the board
LED_SD: U3.E8 (PT13A); also elsewhere on the board
unnamed: R47.1, X1.3 (OUT)
unnamed: R66.2, U3.E2 (PL23D/PCLKC7_0)
PCLKT1_0: R47.2; also elsewhere on the board
PCLKT7_0: U3.F2 (PL23C/PCLKT7_0)
QSPI_D2: U3.Y2 (PB9B/D2/IO2); also elsewhere on the board
QSPI_D3: U3.W1 (PB9A/D3/IO3); also elsewhere on the board
SD_CD: U3.C6 (PT11A); also elsewhere on the board
SD_CK: U3.A6 (PT4A); also elsewhere on the board
SD_CMD: U3.E6 (PT6A); also elsewhere on the board
SD_DAT0: U3.B6 (PT4B); also elsewhere on the board
SD_DAT1: U3.D6 (PT6B); also elsewhere on the board
SD_DAT2: U3.D7 (PT9B); also elsewhere on the board
SD_DAT3: U3.E7 (PT9A); also elsewhere on the board
SPI_CONFIG_MISO: U3.V2 (PB11A/D1/MISO/IO1); also elsewhere on the board
SPI_CONFIG_MOSI: U3.W2 (PB11B/D0/MOSI/IO0); also elsewhere on the board
SPI_CONFIG_SCK: U3.U3 (CCLK/MCLK/SCK); also elsewhere on the board
SPI_CONFIG_SS: U3.R2 (PB15A/HOLDN/DI/BUSY/CSSPIN/CEN); also elsewhere on the board

Notes on the sheet:
BANK 8
3V3
QSPI Config
LEDS/SDMMC
BANK0 - 3V3
BANK7 - 1V8

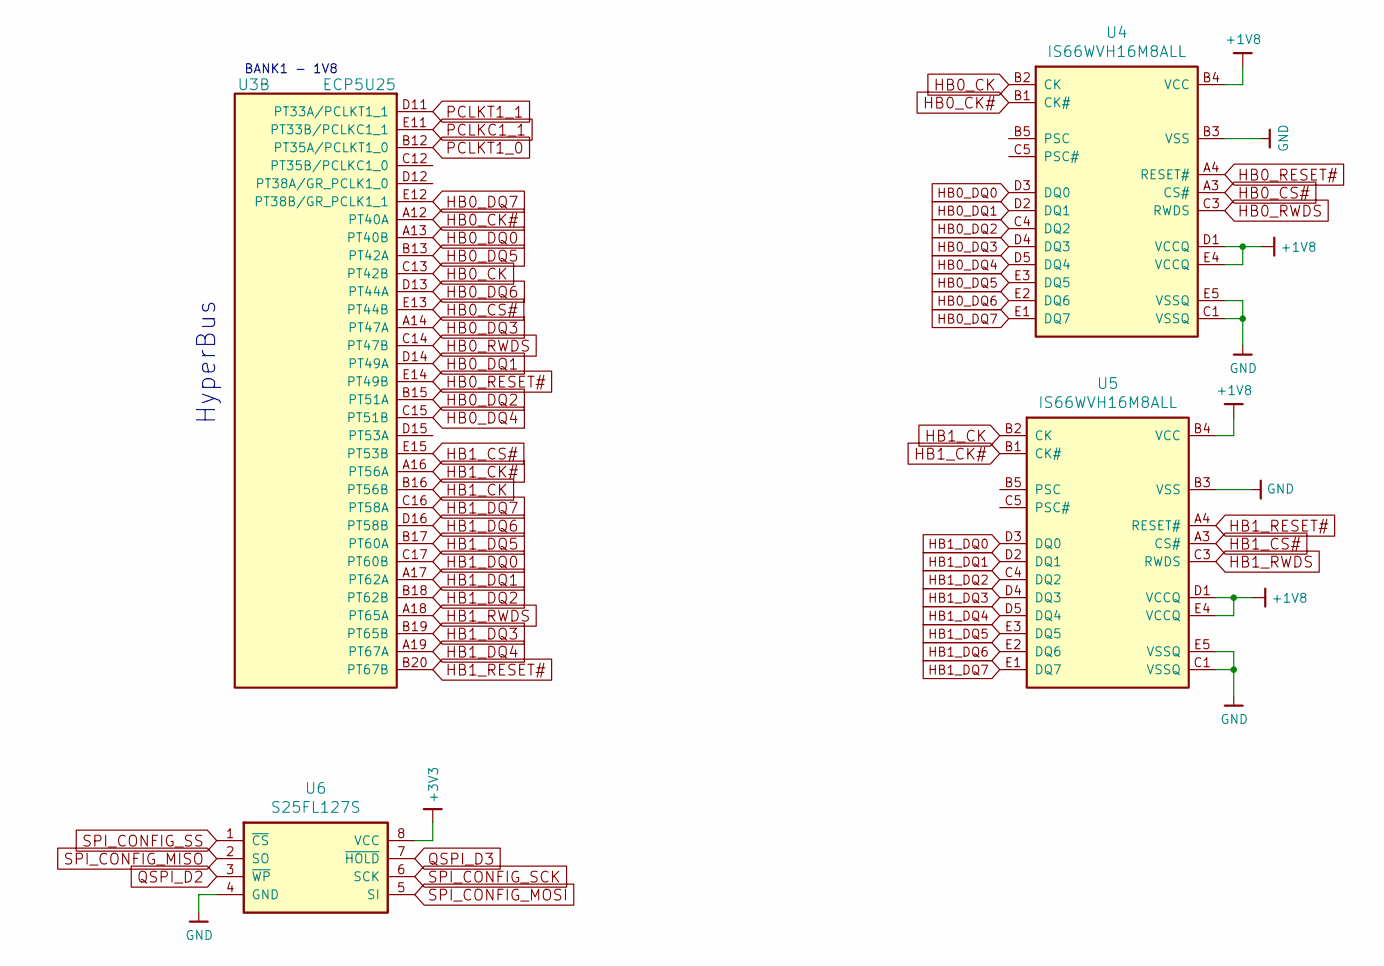
[picture p9: schematic fileHyperRAM.sch, ButterStick]

Parts:
U3: ECP5U25; caBGA_381_17x17
U4, U5: IS66WVH16M8ALL; BGA_24
U6: S25FL127S; SOIJ-8_5.3x5.3mm_P1.27mm

Connections:
+1V8: U4.B4 (VCC), U4.D1 (VCCQ), U4.E4 (VCCQ), U5.B4 (VCC), U5.D1 (VCCQ), U5.E4 (VCCQ); also elsewhere on the board
+3V3: U6.8 (VCC); also elsewhere on the board
GND: U4.B3 (VSS), U4.C1 (VSSQ), U4.E5 (VSSQ), U5.B3 (VSS), U5.C1 (VSSQ), U5.E5 (VSSQ), U6.4 (GND); also elsewhere on the board
HB0_CK: U3.C13 (PT42B), U4.B2 (CK); also elsewhere on the board
HB0_CK#: U3.A12 (PT40A), U4.B1 (CK#)
HB0_CS#: U3.E13 (PT44B), U4.A3 (CS#)
HB0_DQ0: U3.A13 (PT40B), U4.D3 (DQ0); also elsewhere on the board
HB0_DQ1: U3.D14 (PT49A), U4.D2 (DQ1)
HB0_DQ2: U3.B15 (PT51A), U4.C4 (DQ2)
HB0_DQ3: U3.A14 (PT47A), U4.D4 (DQ3)
HB0_DQ4: U3.C15 (PT51B), U4.D5 (DQ4)
HB0_DQ5: U3.B13 (PT42A), U4.E3 (DQ5)
HB0_DQ6: U3.D13 (PT44A), U4.E2 (DQ6)
HB0_DQ7: U3.E12 (PT38B/GR_PCLK1_1), U4.E1 (DQ7)
HB0_RESET#: U3.E14 (PT49B), U4.A4 (RESET#)
HB0_RWDS: U3.C14 (PT47B), U4.C3 (RWDS); also elsewhere on the board
HB1_CK: U3.B16 (PT56B), U5.B2 (CK); also elsewhere on the board
HB1_CK#: U3.A16 (PT56A), U5.B1 (CK#)
HB1_CS#: U3.E15 (PT53B), U5.A3 (CS#)
HB1_DQ0: U3.C17 (PT60B), U5.D3 (DQ0); also elsewhere on the board
HB1_DQ1: U3.A17 (PT62A), U5.D2 (DQ1)
HB1_DQ2: U3.B18 (PT62B), U5.C4 (DQ2)
HB1_DQ3: U3.B19 (PT65B), U5.D4 (DQ3)
HB1_DQ4: U3.A19 (PT67A), U5.D5 (DQ4)
HB1_DQ5: U3.B17 (PT60A), U5.E3 (DQ5)
HB1_DQ6: U3.D16 (PT58B), U5.E2 (DQ6)
HB1_DQ7: U3.C16 (PT58A), U5.E1 (DQ7)
HB1_RESET#: U3.B20 (PT67B), U5.A4 (RESET#)
HB1_RWDS: U3.A18 (PT65A), U5.C3 (RWDS); also elsewhere on the board
PCLKC1_1: U3.E11 (PT33B/PCLKC1_1)
PCLKT1_0: U3.B12 (PT35A/PCLKT1_0); also elsewhere on the board
PCLKT1_1: U3.D11 (PT33A/PCLKT1_1)
QSPI_D2: U6.3 (~WP); also elsewhere on the board
QSPI_D3: U6.7 (~HOLD); also elsewhere on the board
SPI_CONFIG_MISO: U6.2 (SO); also elsewhere on the board
SPI_CONFIG_MOSI: U6.5 (SI); also elsewhere on the board
SPI_CONFIG_SCK: U6.6 (SCK); also elsewhere on the board
SPI_CONFIG_SS: U6.1 (~CS); also elsewhere on the board

Notes on the sheet:
HyperBus
BANK1 - 1V8

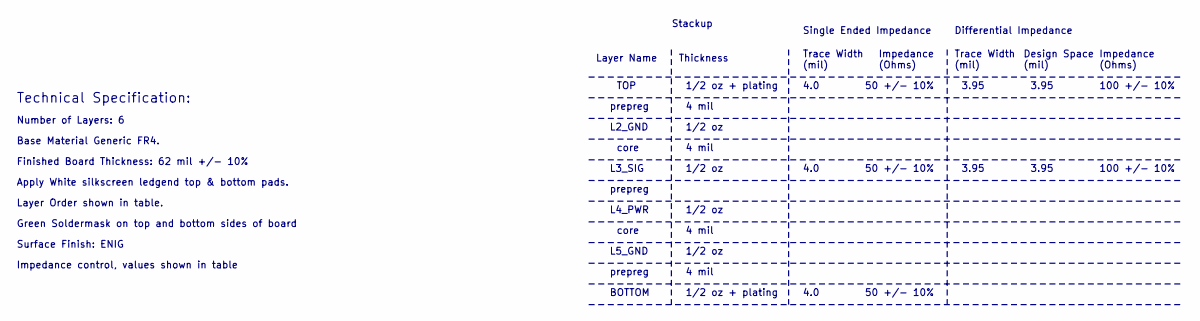
[picture p10: schematic PCBSpecs.sch, ButterStick]

Notes on the sheet:
Stackup
Layer Name
TOP
prepreg
L2_GND
core
L3_SIG
L4_PWR
L5_GND
BOTTOM
Thickness
1/2 oz + plating
1/2 oz
4 mil
Finished Board Thickness: 62 mil +/- 10%
Trace Width (mil)
Single Ended Impedance
Impedance (Ohms)
Differential Impedance
Design Space (mil)
4.0
50 +/- 10%
3.95
3.95
100 +/- 10%
Number of Layers: 6
Base Material Generic FR4.
Apply White silkscreen ledgend top & bottom pads.
Layer Order shown in table.
Surface Finish: ENIG
Green Soldermask on top and bottom sides of board
Impedance control, values shown in table
Technical Specification:

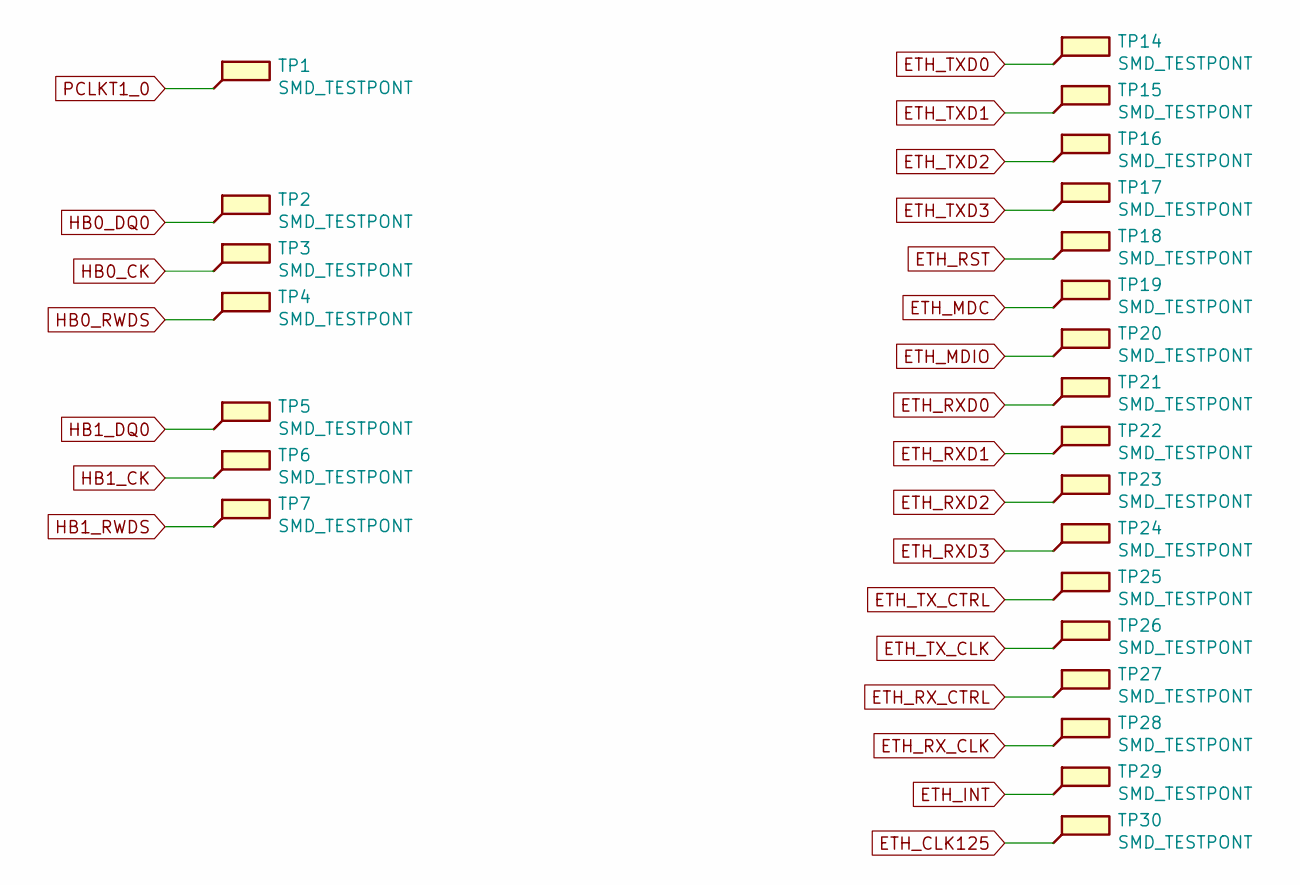
[picture p11: schematic TestPonts.sch, ButterStick]

Parts:
TP1, TP2, TP3, TP4, TP5, TP6, TP7, TP14, TP15, TP16, TP17, TP18, TP19, TP20, TP21, TP22, TP23, TP24, TP25, TP26, TP27, TP28, TP29, TP30: SMD_TESTPONT; TestPoint_Pad_D1.0mm

Connections:
ETH_CLK125: TP30.1; also elsewhere on the board
ETH_INT: TP29.1; also elsewhere on the board
ETH_MDC: TP19.1; also elsewhere on the board
ETH_MDIO: TP20.1; also elsewhere on the board
ETH_RST: TP18.1; also elsewhere on the board
ETH_RXD0: TP21.1; also elsewhere on the board
ETH_RXD1: TP22.1; also elsewhere on the board
ETH_RXD2: TP23.1; also elsewhere on the board
ETH_RXD3: TP24.1; also elsewhere on the board
ETH_RX_CLK: TP28.1; also elsewhere on the board
ETH_RX_CTRL: TP27.1; also elsewhere on the board
ETH_TXD0: TP14.1; also elsewhere on the board
ETH_TXD1: TP15.1; also elsewhere on the board
ETH_TXD2: TP16.1; also elsewhere on the board
ETH_TXD3: TP17.1; also elsewhere on the board
ETH_TX_CLK: TP26.1; also elsewhere on the board
ETH_TX_CTRL: TP25.1; also elsewhere on the board
HB0_CK: TP3.1; also elsewhere on the board
HB0_DQ0: TP2.1; also elsewhere on the board
HB0_RWDS: TP4.1; also elsewhere on the board
HB1_CK: TP6.1; also elsewhere on the board
HB1_DQ0: TP5.1; also elsewhere on the board
HB1_RWDS: TP7.1; also elsewhere on the board
PCLKT1_0: TP1.1; also elsewhere on the board

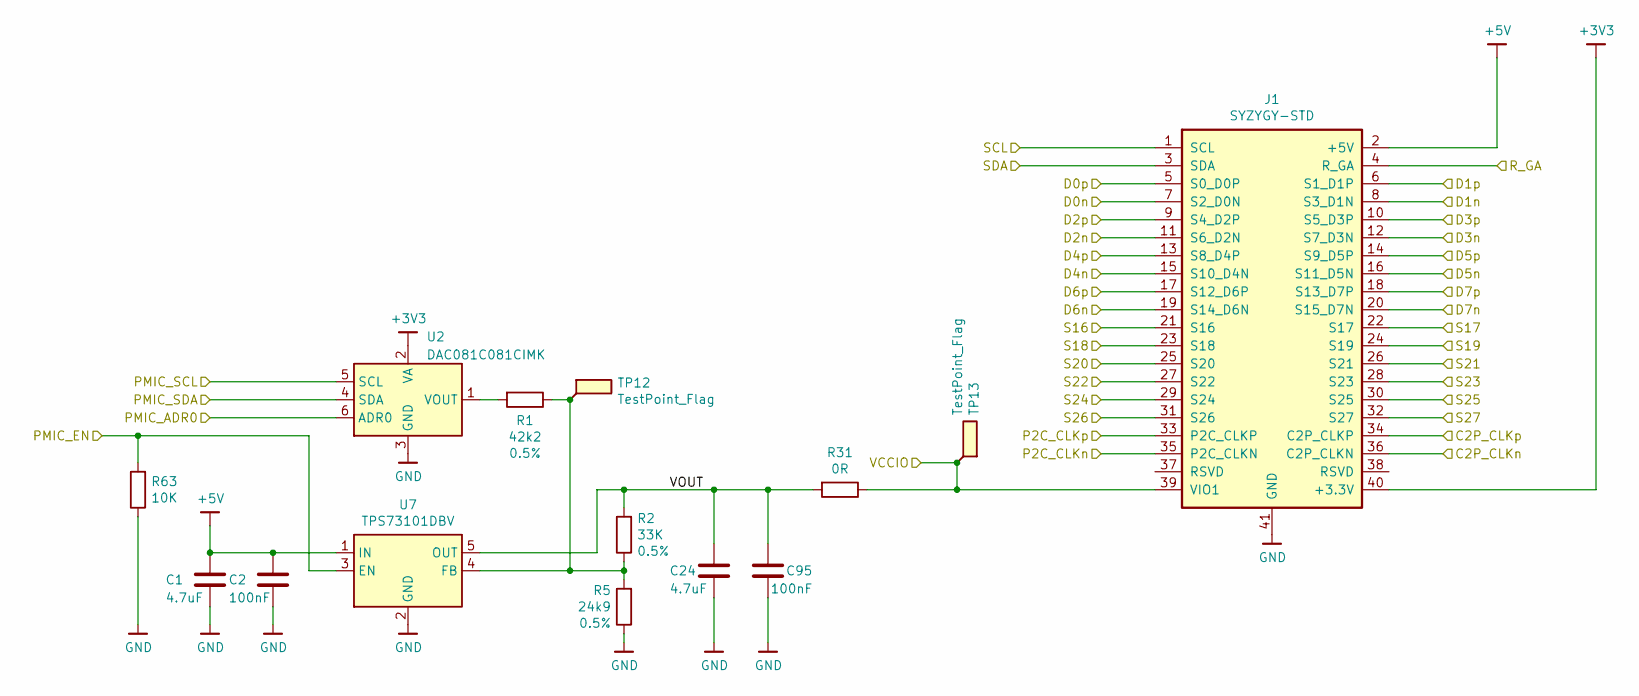
[picture p12: schematic SyzygyStandard.sch, ButterStick]

Parts:
C1, C24: 4.7uF; C_0603
C2, C95: 100nF; C_0402
J1: SYZYGY-STD; SYZYGY_standard_carrier
R1: 42k2; C_0402
R2: 33K; C_0402
R5: 24k9; C_0402
R29: 0R; R_0402
R63: 10K; C_0402
TP10, TP11: TestPoint_Flag; TestPoint_Pad_D1.0mm
U2: DAC081C081CIMK; SOT-23-6
U7: TPS73101DBV; SOT-23-5

Connections:
+3V3: J1.40 (+3.3V), U2.2 (VA), U2.6 (ADR0); also elsewhere on the board
+5V: C1.1, C2.1, J1.2 (+5V), U7.1 (IN); also elsewhere on the board
/SmartVIO/PMIC_SCL: U2.5 (SCL); also elsewhere on the board
/SmartVIO/PMIC_SDA: U2.4 (SDA); also elsewhere on the board
/SmartVIO/SYZYGY_SCL: J1.1 (SCL); also elsewhere on the board
/SmartVIO/SYZYGY_SDA: J1.3 (SDA); also elsewhere on the board
/SyzygyPort0/C2P_CLK_N: J1.36 (C2P_CLKN); also elsewhere on the board
/SyzygyPort0/C2P_CLK_P: J1.34 (C2P_CLKP); also elsewhere on the board
/SyzygyPort0/D0_N: J1.7 (S2_D0N); also elsewhere on the board
/SyzygyPort0/D0_P: J1.5 (S0_D0P); also elsewhere on the board
/SyzygyPort0/D1_N: J1.8 (S3_D1N); also elsewhere on the board
/SyzygyPort0/D1_P: J1.6 (S1_D1P); also elsewhere on the board
/SyzygyPort0/D2_N: J1.11 (S6_D2N); also elsewhere on the board
/SyzygyPort0/D2_P: J1.9 (S4_D2P); also elsewhere on the board
/SyzygyPort0/D3_N: J1.12 (S7_D3N); also elsewhere on the board
/SyzygyPort0/D3_P: J1.10 (S5_D3P); also elsewhere on the board
/SyzygyPort0/D4_N: J1.15 (S10_D4N); also elsewhere on the board
/SyzygyPort0/D4_P: J1.13 (S8_D4P); also elsewhere on the board
/SyzygyPort0/D5_N: J1.16 (S11_D5N); also elsewhere on the board
/SyzygyPort0/D5_P: J1.14 (S9_D5P); also elsewhere on the board
/SyzygyPort0/D6_N: J1.19 (S14_D6N); also elsewhere on the board
/SyzygyPort0/D6_P: J1.17 (S12_D6P); also elsewhere on the board
/SyzygyPort0/D7_N: J1.20 (S15_D7N); also elsewhere on the board
/SyzygyPort0/D7_P: J1.18 (S13_D7P); also elsewhere on the board
/SyzygyPort0/EN: R63.2, U7.3 (EN); also elsewhere on the board
/SyzygyPort0/P2C_CLK_N: J1.35 (P2C_CLKN); also elsewhere on the board
/SyzygyPort0/P2C_CLK_P: J1.33 (P2C_CLKP); also elsewhere on the board
/SyzygyPort0/S16: J1.21 (S16); also elsewhere on the board
/SyzygyPort0/S17: J1.22 (S17); also elsewhere on the board
/SyzygyPort0/S18: J1.23 (S18); also elsewhere on the board
/SyzygyPort0/S19: J1.24 (S19); also elsewhere on the board
/SyzygyPort0/S20: J1.25 (S20); also elsewhere on the board
/SyzygyPort0/S21: J1.26 (S21); also elsewhere on the board
/SyzygyPort0/S22: J1.27 (S22); also elsewhere on the board
/SyzygyPort0/S23: J1.28 (S23); also elsewhere on the board
/SyzygyPort0/S24: J1.29 (S24); also elsewhere on the board
/SyzygyPort0/S25: J1.30 (S25); also elsewhere on the board
/SyzygyPort0/S26: J1.31 (S26); also elsewhere on the board
/SyzygyPort0/S27: J1.32 (S27); also elsewhere on the board
/SyzygyPort0/SyzygyStandard/R_GA: J1.4 (R_GA); also elsewhere on the board
GND: C1.2, C2.2, C24.2, C95.2, J1.41 (GND), R5.1, R63.1, U2.3 (GND), U7.2 (GND); also elsewhere on the board
unnamed: R1.2, U2.1 (VOUT)

Parts of its further copies:
C38, C42, C43, C45: 4.7uF; C_0603
C39, C44, C93, C94: 100nF; C_0402
J3, J5: SYZYGY-STD; SYZYGY_standard_carrier
R6, R18: 42k2; C_0402
R16, R22: 33K; C_0402
R17, R23: 24k9; C_0402
R30, R31: 0R; R_0402
R53, R54: 10K; C_0402
TP8, TP9, TP12, TP13: TestPoint_Flag; TestPoint_Pad_D1.0mm
U12, U17: DAC081C081CIMK; SOT-23-6
U16, U18: TPS73101DBV; SOT-23-5

Connections of its further copies:
+3V3: J3.40 (+3.3V), J5.40 (+3.3V), U12.2 (VA), U17.2 (VA); also elsewhere on the board
+5V: C38.1, C39.1, C43.1, C44.1, J3.2 (+5V), J5.2 (+5V), U16.1 (IN), U18.1 (IN); also elsewhere on the board
/SmartVIO/PMIC_SCL: U12.5 (SCL), U17.5 (SCL); also elsewhere on the board
/SmartVIO/PMIC_SDA: U12.4 (SDA), U17.4 (SDA); also elsewhere on the board
/SmartVIO/SYZYGY_SCL: J3.1 (SCL), J5.1 (SCL); also elsewhere on the board
/SmartVIO/SYZYGY_SDA: J3.3 (SDA), J5.3 (SDA); also elsewhere on the board
/SyzygyPort1/C2P_CLK_N: J3.36 (C2P_CLKN); also elsewhere on the board
/SyzygyPort1/C2P_CLK_P: J3.34 (C2P_CLKP); also elsewhere on the board
/SyzygyPort1/D0_N: J3.7 (S2_D0N); also elsewhere on the board
/SyzygyPort1/D0_P: J3.5 (S0_D0P); also elsewhere on the board
/SyzygyPort1/D1_N: J3.8 (S3_D1N); also elsewhere on the board
/SyzygyPort1/D1_P: J3.6 (S1_D1P); also elsewhere on the board
/SyzygyPort1/D2_N: J3.11 (S6_D2N); also elsewhere on the board
/SyzygyPort1/D2_P: J3.9 (S4_D2P); also elsewhere on the board
/SyzygyPort1/D3_N: J3.12 (S7_D3N); also elsewhere on the board
/SyzygyPort1/D3_P: J3.10 (S5_D3P); also elsewhere on the board
/SyzygyPort1/D4_N: J3.15 (S10_D4N); also elsewhere on the board
/SyzygyPort1/D4_P: J3.13 (S8_D4P); also elsewhere on the board
/SyzygyPort1/D5_N: J3.16 (S11_D5N); also elsewhere on the board
/SyzygyPort1/D5_P: J3.14 (S9_D5P); also elsewhere on the board
/SyzygyPort1/D6_N: J3.19 (S14_D6N); also elsewhere on the board
/SyzygyPort1/D6_P: J3.17 (S12_D6P); also elsewhere on the board
/SyzygyPort1/D7_N: J3.20 (S15_D7N); also elsewhere on the board
/SyzygyPort1/D7_P: J3.18 (S13_D7P); also elsewhere on the board
/SyzygyPort1/EN: R54.2, U16.3 (EN); also elsewhere on the board
/SyzygyPort1/P2C_CLK_N: J3.35 (P2C_CLKN); also elsewhere on the board
/SyzygyPort1/P2C_CLK_P: J3.33 (P2C_CLKP); also elsewhere on the board
/SyzygyPort1/S16: J3.21 (S16); also elsewhere on the board
/SyzygyPort1/S17: J3.22 (S17); also elsewhere on the board
/SyzygyPort1/S18: J3.23 (S18); also elsewhere on the board
/SyzygyPort1/S19: J3.24 (S19); also elsewhere on the board
/SyzygyPort1/S20: J3.25 (S20); also elsewhere on the board
/SyzygyPort1/S21: J3.26 (S21); also elsewhere on the board
/SyzygyPort1/S22: J3.27 (S22); also elsewhere on the board
/SyzygyPort1/S23: J3.28 (S23); also elsewhere on the board
/SyzygyPort1/S24: J3.29 (S24); also elsewhere on the board
/SyzygyPort1/S25: J3.30 (S25); also elsewhere on the board
/SyzygyPort1/S26: J3.31 (S26); also elsewhere on the board
/SyzygyPort1/S27: J3.32 (S27); also elsewhere on the board
/SyzygyPort1/sheet5C8A3B42/R_GA: J3.4 (R_GA); also elsewhere on the board
/SyzygyPort1/sheet5C8A3B42/VOUT: C42.1, C94.1, R16.2, R30.2, U16.5 (OUT)
/SyzygyPort2/C2P_CLK_N: J5.36 (C2P_CLKN); also elsewhere on the board
/SyzygyPort2/C2P_CLK_P: J5.34 (C2P_CLKP); also elsewhere on the board
/SyzygyPort2/D0_N: J5.7 (S2_D0N); also elsewhere on the board
/SyzygyPort2/D0_P: J5.5 (S0_D0P); also elsewhere on the board
/SyzygyPort2/D1_N: J5.8 (S3_D1N); also elsewhere on the board
/SyzygyPort2/D1_P: J5.6 (S1_D1P); also elsewhere on the board
/SyzygyPort2/D2_N: J5.11 (S6_D2N); also elsewhere on the board
/SyzygyPort2/D2_P: J5.9 (S4_D2P); also elsewhere on the board
/SyzygyPort2/D3_N: J5.12 (S7_D3N); also elsewhere on the board
/SyzygyPort2/D3_P: J5.10 (S5_D3P); also elsewhere on the board
/SyzygyPort2/D4_N: J5.15 (S10_D4N); also elsewhere on the board
/SyzygyPort2/D4_P: J5.13 (S8_D4P); also elsewhere on the board
/SyzygyPort2/D5_N: J5.16 (S11_D5N); also elsewhere on the board
/SyzygyPort2/D5_P: J5.14 (S9_D5P); also elsewhere on the board
/SyzygyPort2/D6_N: J5.19 (S14_D6N); also elsewhere on the board
/SyzygyPort2/D6_P: J5.17 (S12_D6P); also elsewhere on the board
/SyzygyPort2/D7_N: J5.20 (S15_D7N); also elsewhere on the board
/SyzygyPort2/D7_P: J5.18 (S13_D7P); also elsewhere on the board
/SyzygyPort2/EN: R53.2, U18.3 (EN); also elsewhere on the board
/SyzygyPort2/P2C_CLK_N: J5.35 (P2C_CLKN); also elsewhere on the board
/SyzygyPort2/P2C_CLK_P: J5.33 (P2C_CLKP); also elsewhere on the board
/SyzygyPort2/S16: J5.21 (S16); also elsewhere on the board
/SyzygyPort2/S17: J5.22 (S17); also elsewhere on the board
/SyzygyPort2/S18: J5.23 (S18); also elsewhere on the board
/SyzygyPort2/S19: J5.24 (S19); also elsewhere on the board
/SyzygyPort2/S20: J5.25 (S20); also elsewhere on the board
/SyzygyPort2/S21: J5.26 (S21); also elsewhere on the board
/SyzygyPort2/S22: J5.27 (S22); also elsewhere on the board
/SyzygyPort2/S23: J5.28 (S23); also elsewhere on the board
/SyzygyPort2/S24: J5.29 (S24); also elsewhere on the board
/SyzygyPort2/S25: J5.30 (S25); also elsewhere on the board
/SyzygyPort2/S26: J5.31 (S26); also elsewhere on the board
/SyzygyPort2/S27: J5.32 (S27); also elsewhere on the board
/SyzygyPort2/sheet5C8EBAFC/PMIC_ADR0: U17.6 (ADR0)
/SyzygyPort2/sheet5C8EBAFC/R_GA: J5.4 (R_GA); also elsewhere on the board
GND: C38.2, C39.2, C42.2, C43.2, C44.2, C45.2, C93.2, C94.2, J3.41 (GND), J5.41 (GND), R17.1, R23.1, R53.1, R54.1, U12.3 (GND), U12.6 (ADR0), U16.2 (GND), U17.3 (GND), U18.2 (GND); also elsewhere on the board
unnamed: R6.2, U12.1 (VOUT)
unnamed: R18.1, R22.1, R23.2, TP8.1, U18.4 (FB)
unnamed: R18.2, U17.1 (VOUT)

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
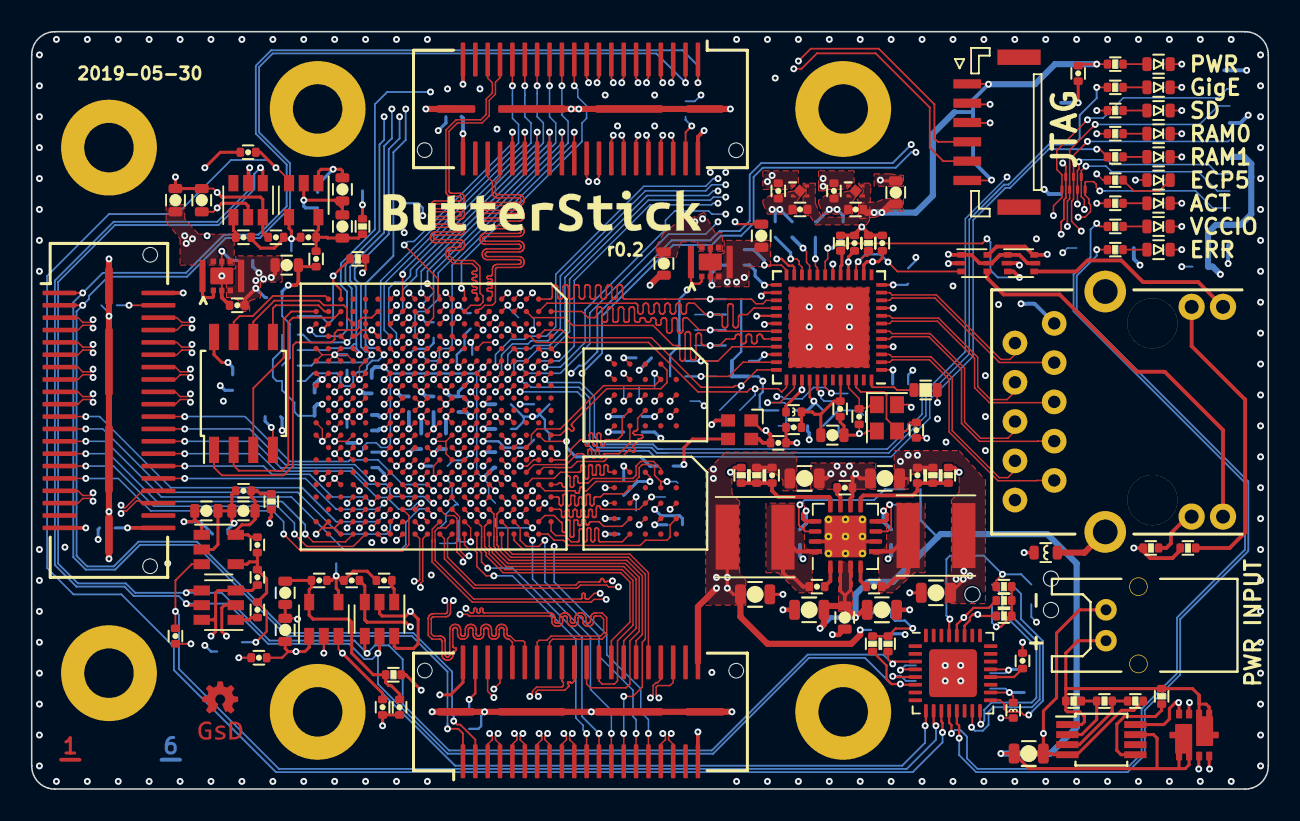
[picture p13: board hardware/ButterStick_r0.2/ButterStick.kicad_pcb from above]

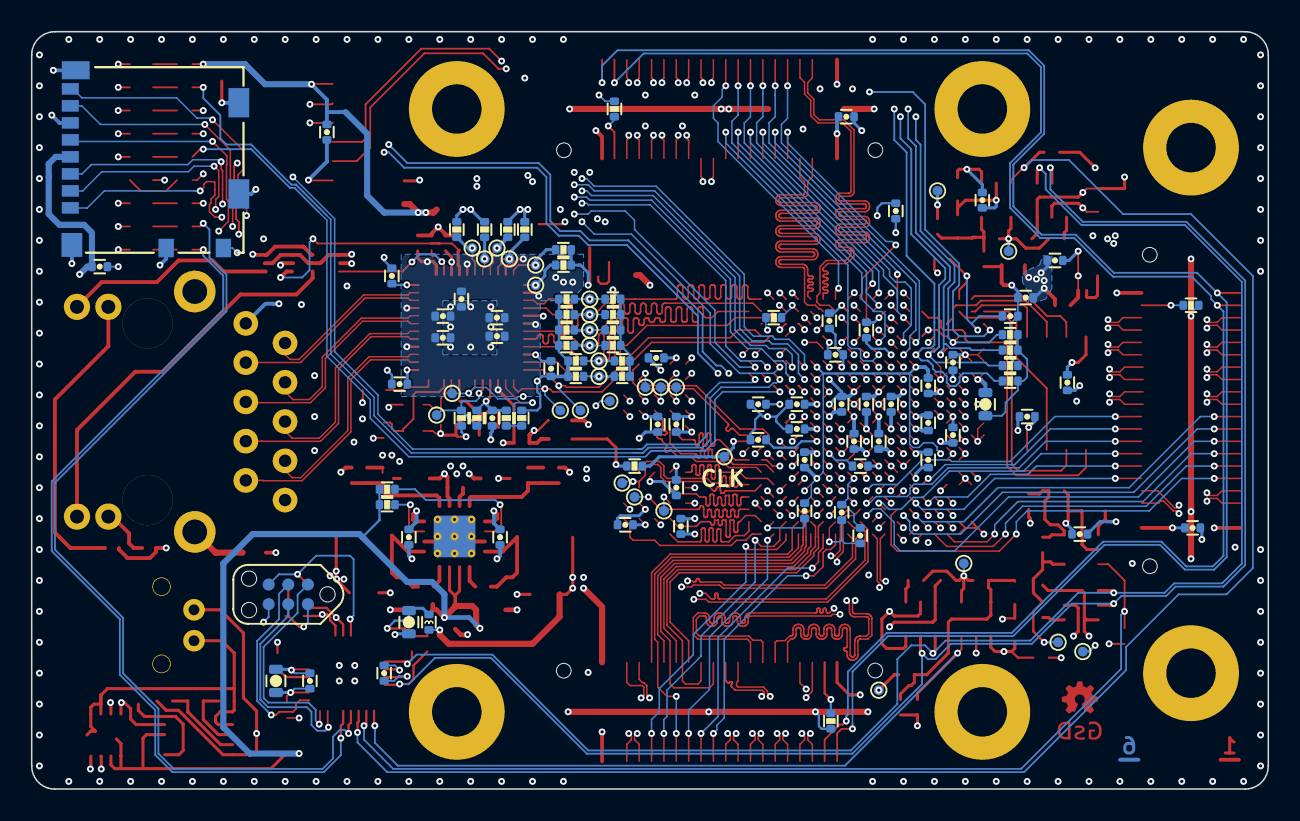
[picture p14: board hardware/ButterStick_r0.2/ButterStick.kicad_pcb from below]

Board: 6 copper layers, 80.0 x 49.0 mm, 253 parts (122 on the bottom side), 252 nets.
